ErichStyger/MCU-Link-MR/README.md

# MCU-Link-MR

Project for the NXP MCU-Link Debug Probe with KiCAD, as a debug drone for mobile robotics platforms.

This project is hosted on GitHub: https://github.com/ErichStyger/MCU-Link-MR

See https://mcuoneclipse.com/2024/05/05/cmsis-dap-debug-probe-for-robots-and-pixhawk-with-kicad/

You can order the v0.2 board as produced by NXP: https://www.nxp.com/design/design-center/software/development-software/mcuxpresso-software-and-tools-/mcu-link-mr-debug-probe-with-usb-c-serial-and-mobile-robotics-i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. See the package content and getting started at https://mcuoneclipse.com/2025/04/13/mcu-link-mr-affordable-cmsis-dap-debug-probe-for-robotics-and-beyond/ 

## Features
The MCU-Link-MR is an open source debug probe, based on the original [NXP MCU-Link](https://www.nxp.com/design/design-center/software/development-software/mcuxpresso-software-and-tools-/mcu-link-debug-probe:MCU-LINK).

The MCU-Link-MR supports debugging ARM-Cortex devices plus includes multiple headers used for robots and drone projects.

- Binary firmware compatibility with the original MCU-Link debug probe
- Size: 58x40 mm, dual-layer PCB
- Laser-cut top-cover enclosure
- USB-C host connector
- Reset button for debug probe (LPC55S69) and target
- [ARM target debug header (10pin 2x1.27 mm)](https://developer.arm.com/documentation/101416/0100/Hardware-Description/Target-Interfaces/Cortex-Debug--10-pin-) to debug any ARM Cortex target
- Multiple robot and drone debug and UART connectors:
    - [Pixhawk Debug Full debug header (10pin JST-SH)](https://docs.px4.io/main/en/debug/swd_debug.html#pixhawk-debug-full) with UART
    - [Pixhawk Debug Mini debug header (6pin JST-SH)](https://docs.px4.io/main/en/debug/swd_debug.html#pixhawk-debug-mini) with UART
    - [DCD-LZ Debug header (7pin JST-GHS)](https://nxp.gitbook.io/hovergames/rddrone-fmuk66/connectors/debug-interface-dcd-lz) with UART
    - [Target UART for NavQPlus Companion Computer (6pin JST-GH)](https://nxp.gitbook.io/navqplus/hardware/hardware-interfaces/uart/uart2-a53-debug), supporting flow control (CTS/RTS) (with board rev 0.4 or later)

## PCB
Renderings below show the v0.2 version.
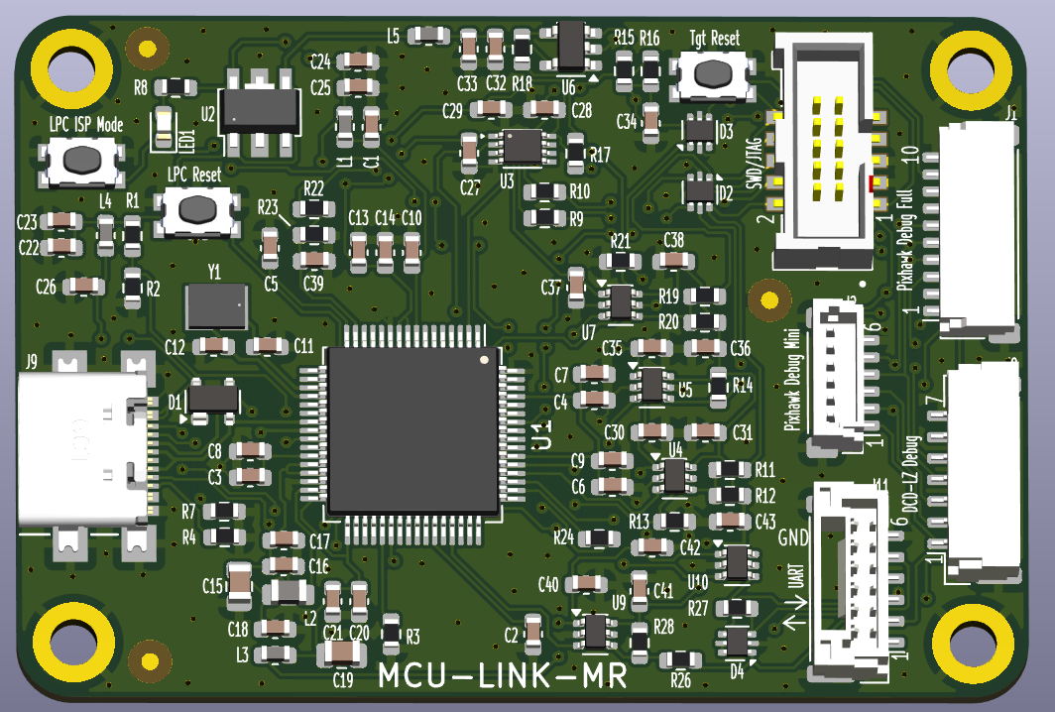
[picture p1: images/top_v0.2.png]
top PCB

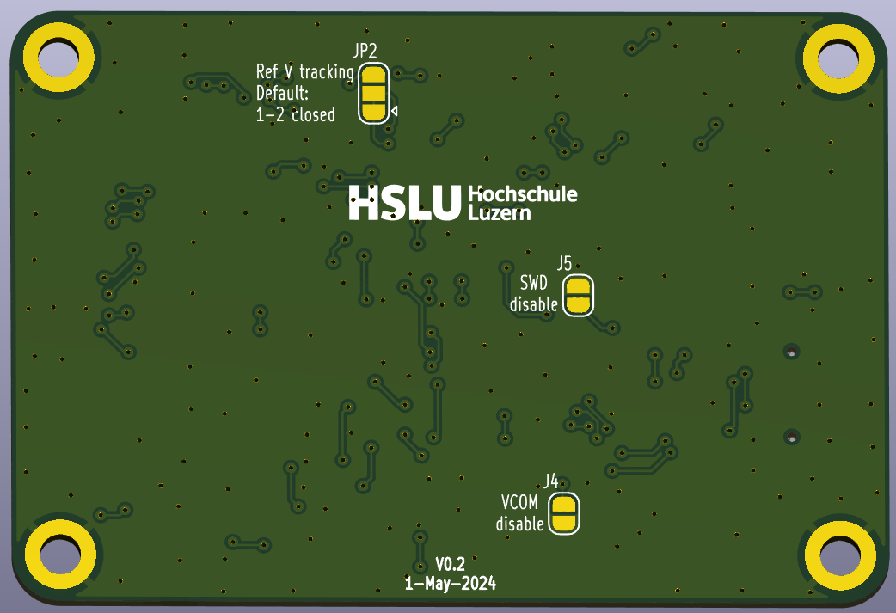
[picture p2: images/bottom_v0.2.png]
bottom PCB

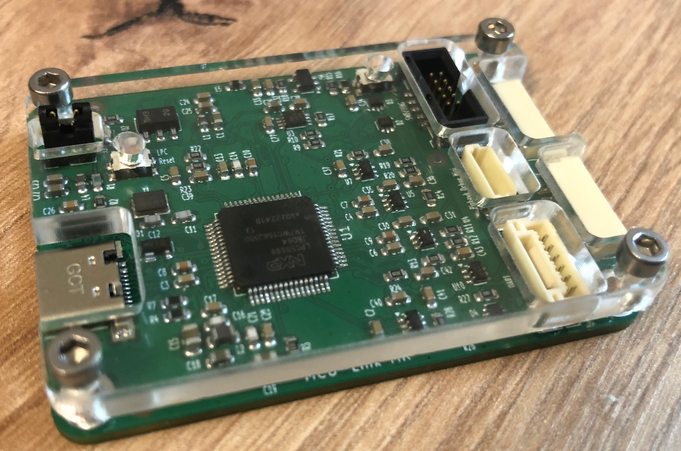
[picture p3: images/enclosure_v0.1.png]
enclosure


### v0.1
The first v0.1 version and the v0.2 version:

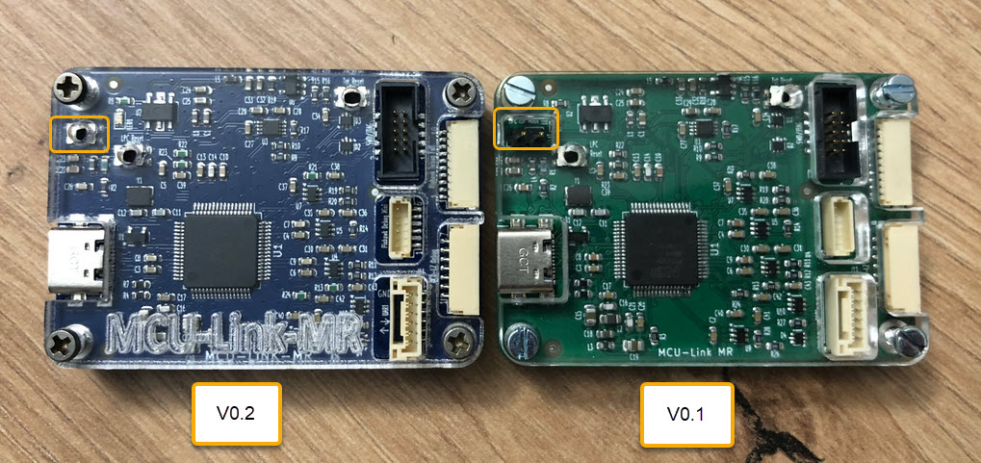
[picture p4: images/mcu-link-mr-v0.1-v0.2.jpg]
v0.1 and v0.2


### v0.2
PCB of the v0.2:

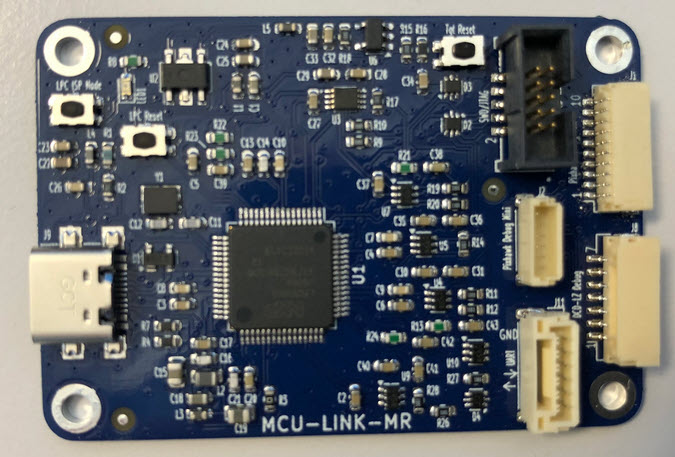
[picture p5: images/mcu-link-mr-v0.2.jpg]

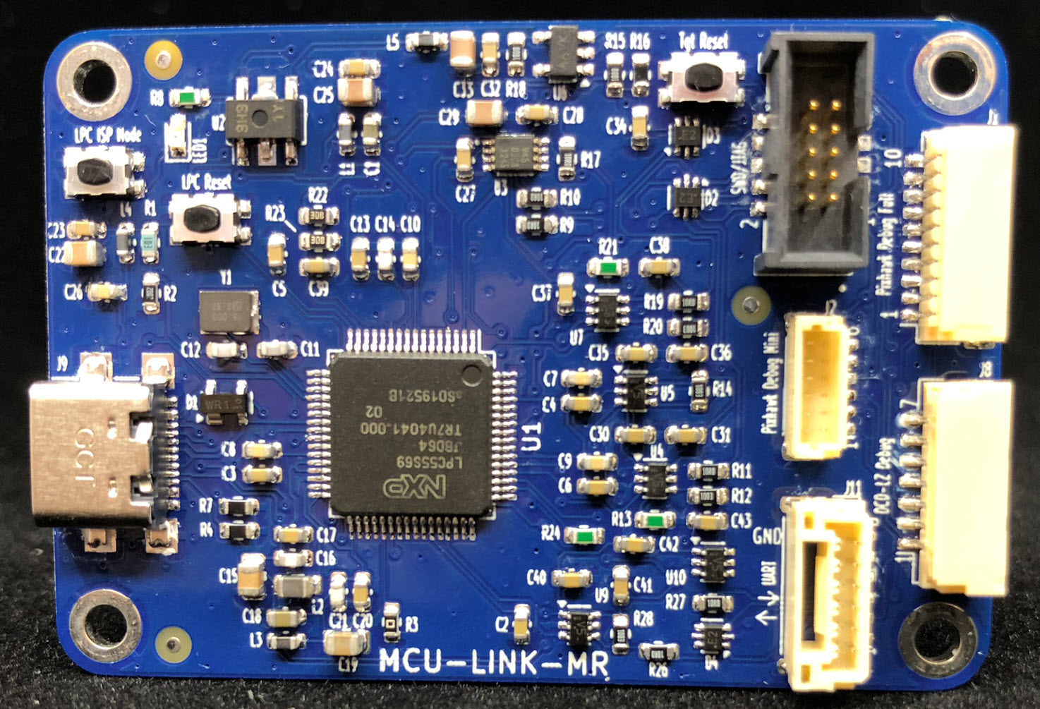
[picture p6: images/v0.2.jpg]

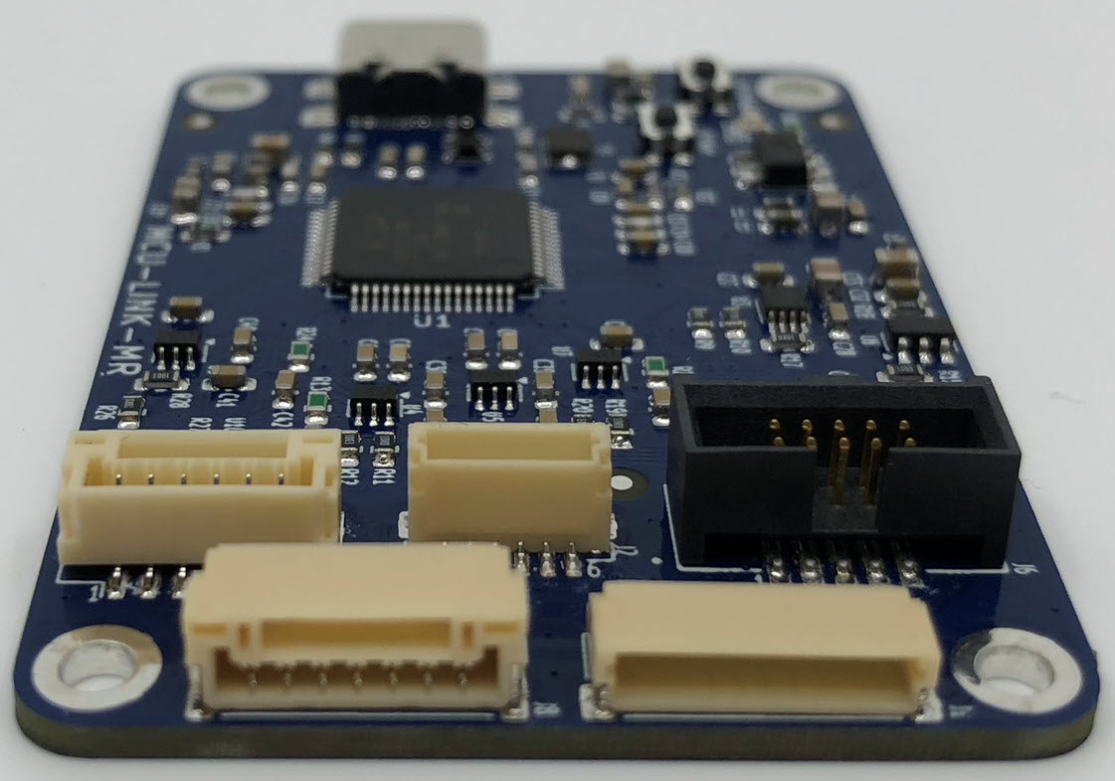
[picture p7: images/v0.2_side1.jpg]
v0.2 side 1

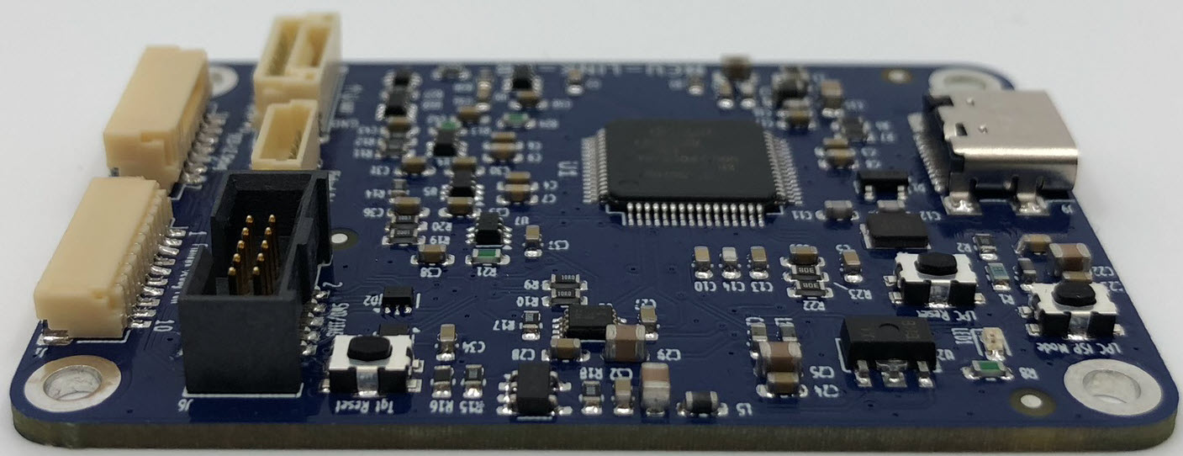
[picture p8: images/v0.2_side2.jpg]
v0.2 side 2

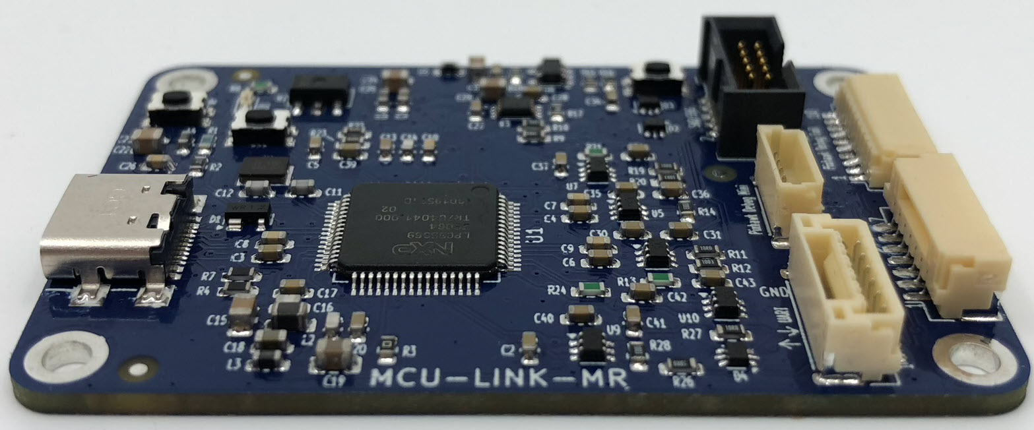
[picture p9: images/v0.2_side3.jpg]
v0.2 side 3

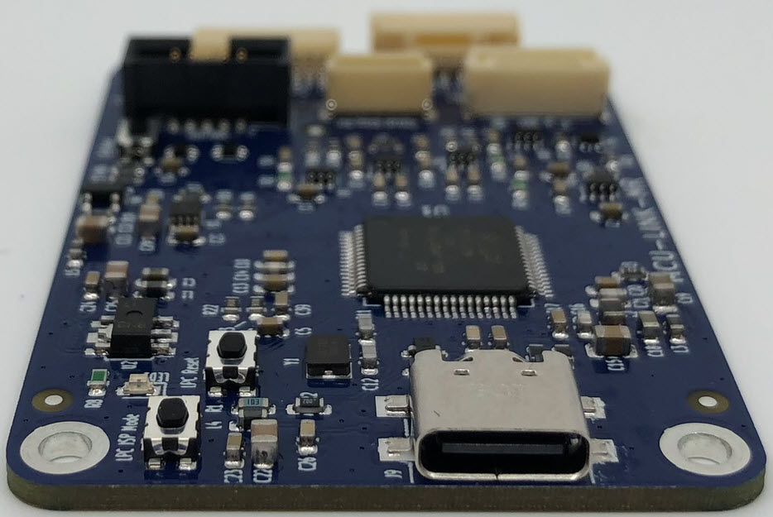
[picture p10: images/v0.2_side4.jpg]
v0.2 side 4


### v0.3
PCB of the v0.3:

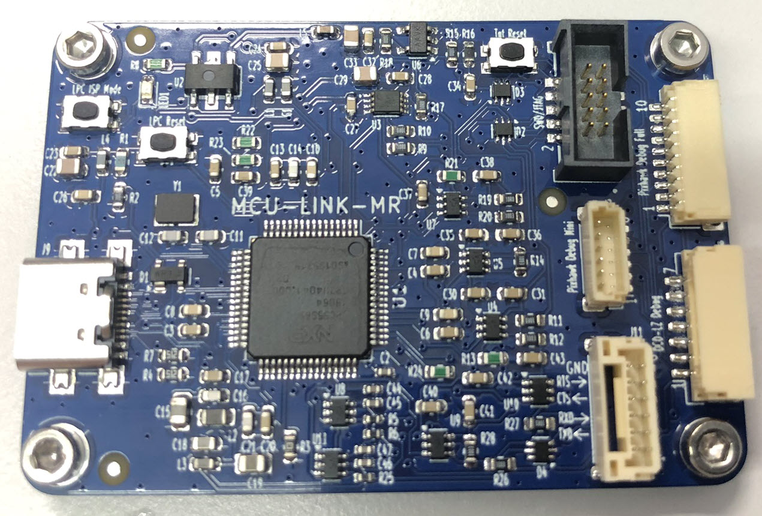
[picture p11: images/mcu-link-mr-v0.3.jpg]
v0.3 PCB

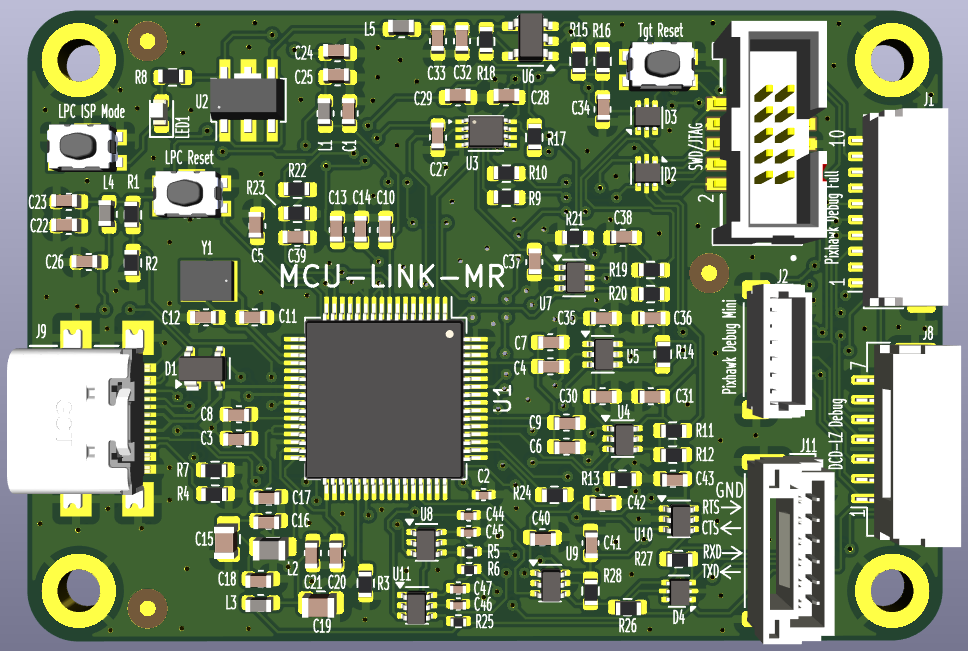
[picture p12: images/top_v0.3.png]
v0.3 top PCB

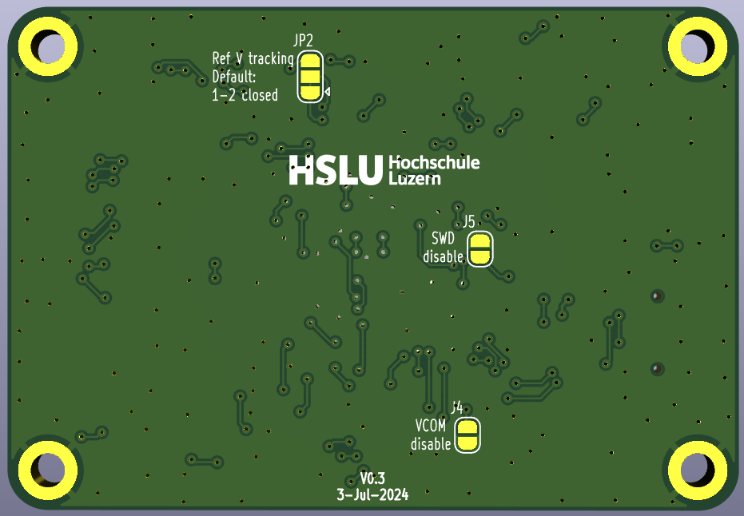
[picture p13: images/bottom_v0.3.png]
v0.3 bottom PCB


### v0.4
PCB of the v0.4:

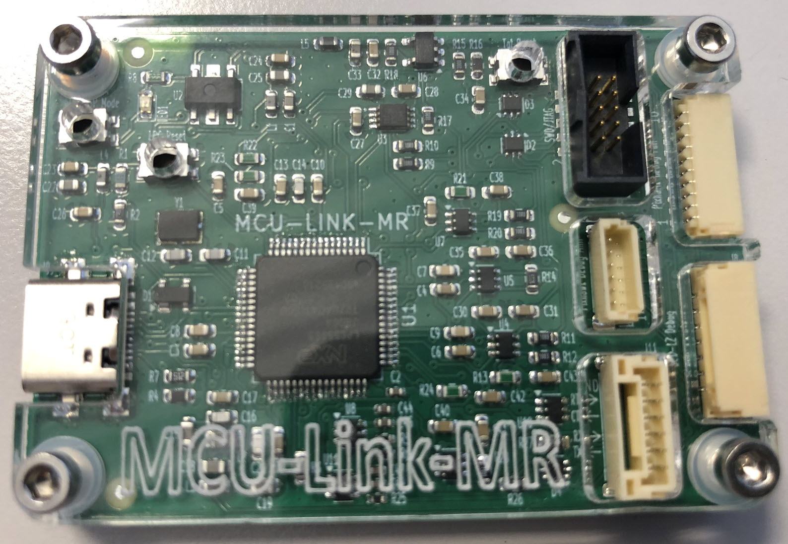
[picture p14: images/mcu-link-mr-v0.4.jpg]
v0.4 PCB

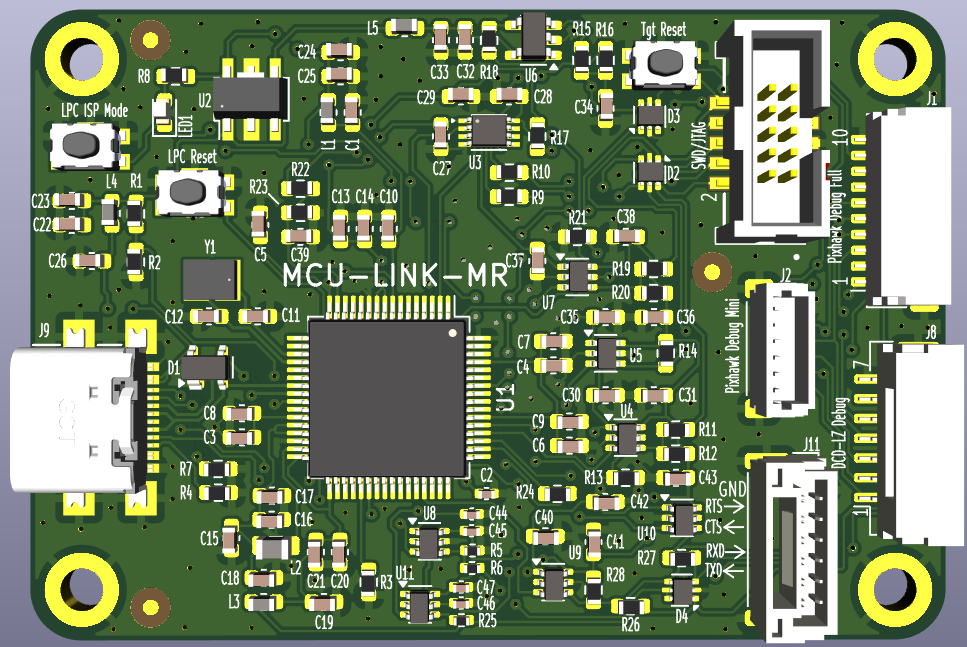
[picture p15: images/top_v0.4.png]
v0.4 top PCB

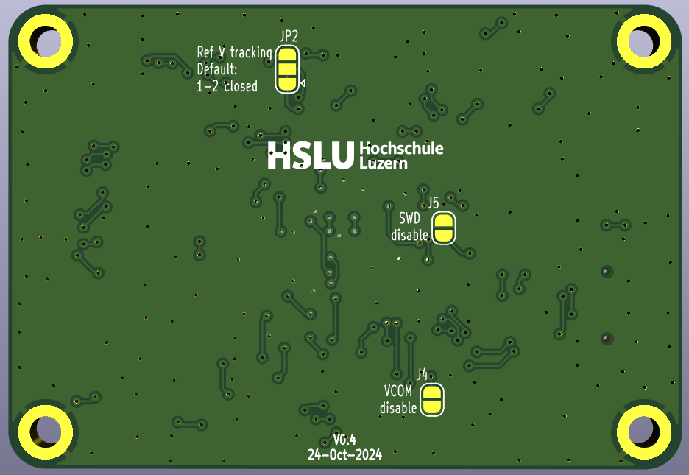
[picture p16: images/bottom_v0.4.png]
v0.4 bottom PCB


PCB of the v0.5:

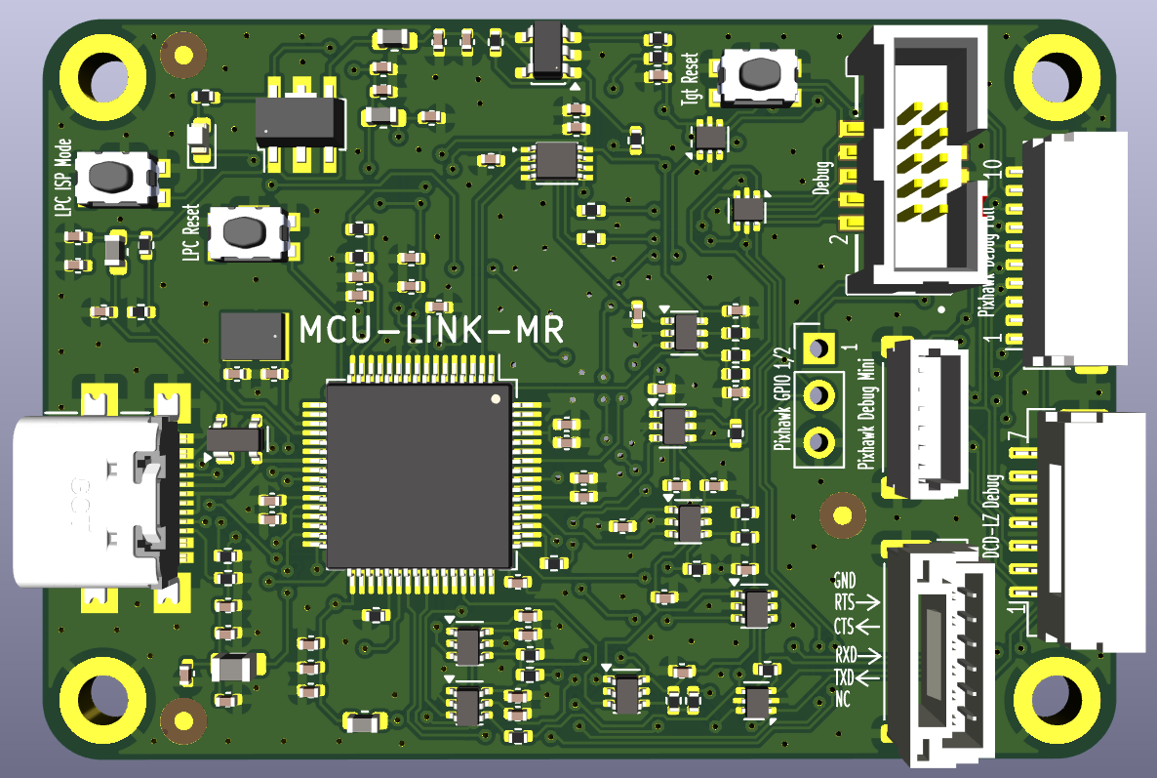
[picture p17: images/top_v0.5.png]
v0.45 top PCB

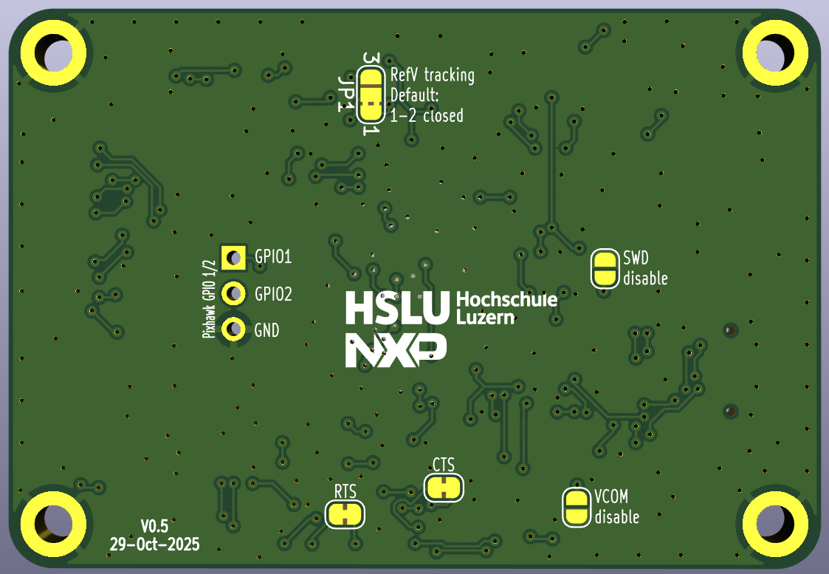
[picture p18: images/bottom_v0.5.png]
v0.5 bottom PCB

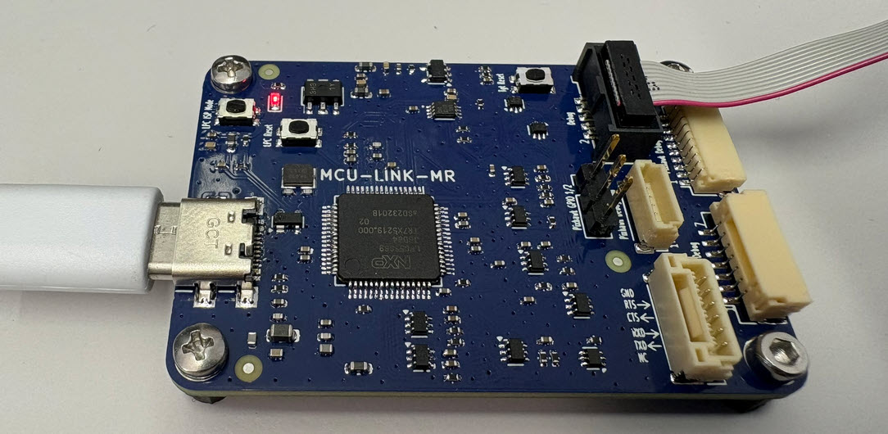
[picture p19: images/mcu-link-mr-v05.jpg]
v0.5 PCB


## Versions
The gerber files for the different releases can be found in KiCAD project directory.

### v0.5
- Upgraded to KiCad v9.0
- added isolation solder-jumpers for RTS and CTS
- changed Resistor and Capacitor size from 0603 to 0402
- removed all designators on silkscreen
- added 3 pin 2.54mm Pixhawk header for logic analyzer access
- added NXP logo on the back
- see https://mcuoneclipse.com/2025/12/29/mcu-link-mr-v0-5-enhanced-debug-probe-for-arm-cortex-m/

### v0.4
- fixed pull-up on CTS line to pull-down

### v0.3
- Added RTS/CTS signals with level shifters for J11/NavQPlus connector
- Issue: this PCB has pull-ups for the CTS line instead of pull-down. Fixed in v0.4

### v0.2
- Improved footprints and silkscreen
- Push button instead of jumper for DFU mode
- fixed UART connection on debug headers

### v0.1
- Initial version
- Issue with UART on debug headers (works fine on UART header) (fixed in v0.2)

## PCB Production
PCBs have been produced by PCBWay (https://www.pcbway.com/), with following settings:
- Size: 58x40 mm
- Layers: 2
- Soldermask (top, bottom): blue *(Note: green is possible too, PCBWay won't accept black because this requires minimal 0.22 mm soldermask distance between pins)*
- Silkscreen (top, bottom): white
- Material: FR4, TG 150-160
- Thickness: 1.6 mm
- Min track/spacing: 6/6 mil
- Min hole size: 0.3 mm
- Surface finish: HASL with lead *(Note: for production use HASL lead free or immersion gold (ENIG))*
- Vias: tenting vias
- Finished copper: 1 oz Cu

## Links
- Article about production version: https://mcuoneclipse.com/2025/04/13/mcu-link-mr-affordable-cmsis-dap-debug-probe-for-robotics-and-beyond/
- Article about v0.2: https://mcuoneclipse.com/2024/05/19/mcu-link-mr-v0-2-drone-and-robot-debug-probe-with-uart-2-usb-bridge/
- Article for the project: https://mcuoneclipse.com/2024/05/05/cmsis-dap-debug-probe-for-robots-and-pixhawk-with-kicad/
- Base hardware project used: https://mcuoneclipse.com/2024/02/06/versatile-oshw-mini-mcu-link-debug-probe-external-on-board-or-embedded/, GitHub: https://github.com/ErichStyger/McuLink-Mini
- NXP MCU-Link: https://www.nxp.com/design/design-center/software/development-software/mcuxpresso-software-and-tools-/mcu-link-debug-probe:MCU-LINK
- NXP LinkServer: https://www.nxp.com/design/design-center/software/development-software/mcuxpresso-software-and-tools-/linkserver-for-microcontrollers:LINKERSERVER
- MCU-Link with Cortex-Debug and LinkServer: https://mcuoneclipse.com/2023/11/27/mcu-link-with-cortex-debug-and-linkserver/
- LinkServer for Microcontrollers: https://mcuoneclipse.com/2023/05/14/linkserver-for-microcontrollers/
