ErichStyger/MCU-Link-MR/enclosure/README.md

# Enclosure
Enclosure files (lasercut) for the debug probe.
See file name for the different versions.
