ErichStyger/MCU-Link-MR/KiCAD/README.md

# KiCAD
Folder for KiCAD project and files.
