ErichStyger/MCU-Link-MR/KiCAD/MCU-Link_MR/bom/BOM.xlsx

Mouser | Vendor | Description | 1 | 10
200-SHF10501LDSM | SHF-105-01-L-D-SM | Sockel & Kabelgehäuse Shrouded Terminal Strip, 0.050" pitch | 2.88 | 2.62
771-LPC55S69JBD64K | LPC55S69JBD64K | LPC55S69JBD64 | 8.13 | 5.6
771-74LVC1T45GWQ100H | 74LVC1T45GW-Q100H | voltage converter 74LVC1T45GW-Q100/SOT363/SC-88 | 0.398 | 0.335
771-74LVC2T45DC125 | 74LVC2T45DC,125 | dual voltage converter/Bus transceiver | 0.658 | 0.546
