ErichStyger/MCU-Link-MR/(threads)

Thread 1 (2025-04-02):

MCU-Link-MR bricked after failed firmware update in MCUXpresso, how to recover?

eldux, 2025-04-02:
MCU-Link-MR bricked after failed firmware update in MCUXpresso, how to recover? Pressing ISP button as per instructions here does not work:
https://docs.nxp.com/bundle/UM12219/page/topics/installation_and_firmware_options.html

ErichStyger, 2025-04-02:
You can update it with a script, with or without jumper/button pressed,
See https://mcuoneclipse.com/2024/05/11/updating-mcu-link-cmsis-dap-debug-probe-firmware-jumper-less/, section 'Firmware update script'.

Or use
LinkServer probe #1 update check
and then
LinkServer probe #1 update auto

I hope this helps?
Erich

ErichStyger, 2025-04-02:
Just in case the 'auto' update does not work, here is what I usually do:
a) press the LPC ISP button on the board, and while pressed, plug in the board (USB cable)
b) run the script 'C:\NXP\LinkServer\MCU-LINK_installer\scripts\program_CMSIS.cmd' (Windows)
c) press a key in the launched script as prompted which will re-program the firmware

Below is my output of the script:
```
CMSIS-DAP firmware for MCU-Link programming script V3.153 December 2024.

Place the board in ISP USB mode using the appropriate jumper on your MCU-Link.
Refer to the board documentation for more information.
Connect board via USB then press Space.

WARNING:

This firmware version requires MCUXpresso IDE version 11.7.1 or later.

Press any key to continue . . .

Programming "MCU-LINK_CMSIS-DAP_V3_153.s19"

Programmed successfully - To use: remove ISP jumper and reboot.

Connect Next Board then press Space (or CTRL-C to Quit)

Press any key to continue . . .
```
I hope this helps

eldux, 2025-04-02:
actually i did try to do that and it stuck on ISP mode request:

CMSIS-DAP firmware for MCU-Link programming script V3.153 December 2024.

Place the board in ISP USB mode using the appropriate jumper on your MCU-Link.
Refer to the board documentation for more information.
Connect board via USB then press Space.

WARNING:

This firmware version requires MCUXpresso IDE version 11.7.1 or later.

Press any key to continue . . .

Configure board for ISP mode and connect via USB then press Space.
Press any key to continue . . .
Configure board for ISP mode and connect via USB then press Space.
Press any key to continue . . .
Configure board for ISP mode and connect via USB then press Space.
Press any key to continue . . .
Configure board for ISP mode and connect via USB then press Space.
Press any key to continue . . .
Configure board for ISP mode and connect via USB then press Space.
Press any key to continue . . .
Configure board for ISP mode and connect via USB then press Space.
Press any key to continue . . .
Configure board for ISP mode and connect via USB then press Space.
Press any key to continue . . .

ErichStyger, 2025-04-02:
So the board is not in ISP mode as it seems.
Did you keep the ISP button pressed while powering the board?
In that mode no LED should be on.
(you can release the button after the power-on, but you need to keep it pressed during power-on).

eldux, 2025-04-02:
Yes, it gone like that: I push the button -> plug USB-C -> led goes red, and computer chimes -> depress the button -> no led. I run C:\nxp\LinkServer_25.3.31>linkserver probe #1 update check
and get this:
CRITICAL: Critical error
ERRMSG: Exception: No probes detected

ErichStyger, 2025-04-02:
Strange: LED behavior is correct and same on my side.
Can you run the following when connected in ISP mode:
pnputil /enum-devices /connected | findstr /i "USB\"

It should show a device with VID 1Fc9 and PID 0021:
Instance ID:                USB\VID_1FC9&PID_0021\5&3af188da&0&4

Other than that: maybe you already tried with a different USB cable and with a different machine?

eldux, 2025-04-02:
We have just tied on other PC with other USB-c cable, and your instructions worked now.

ErichStyger, 2025-04-02:
Great that this hint worked :-).
I'm wondering: was it the USB cable or the PC, or both?
