ErichStyger/MCU-Link-MR/KiCAD/MCU-Link_MR/v0.5/Schematics MCU-Link-MR v0.5.pdf

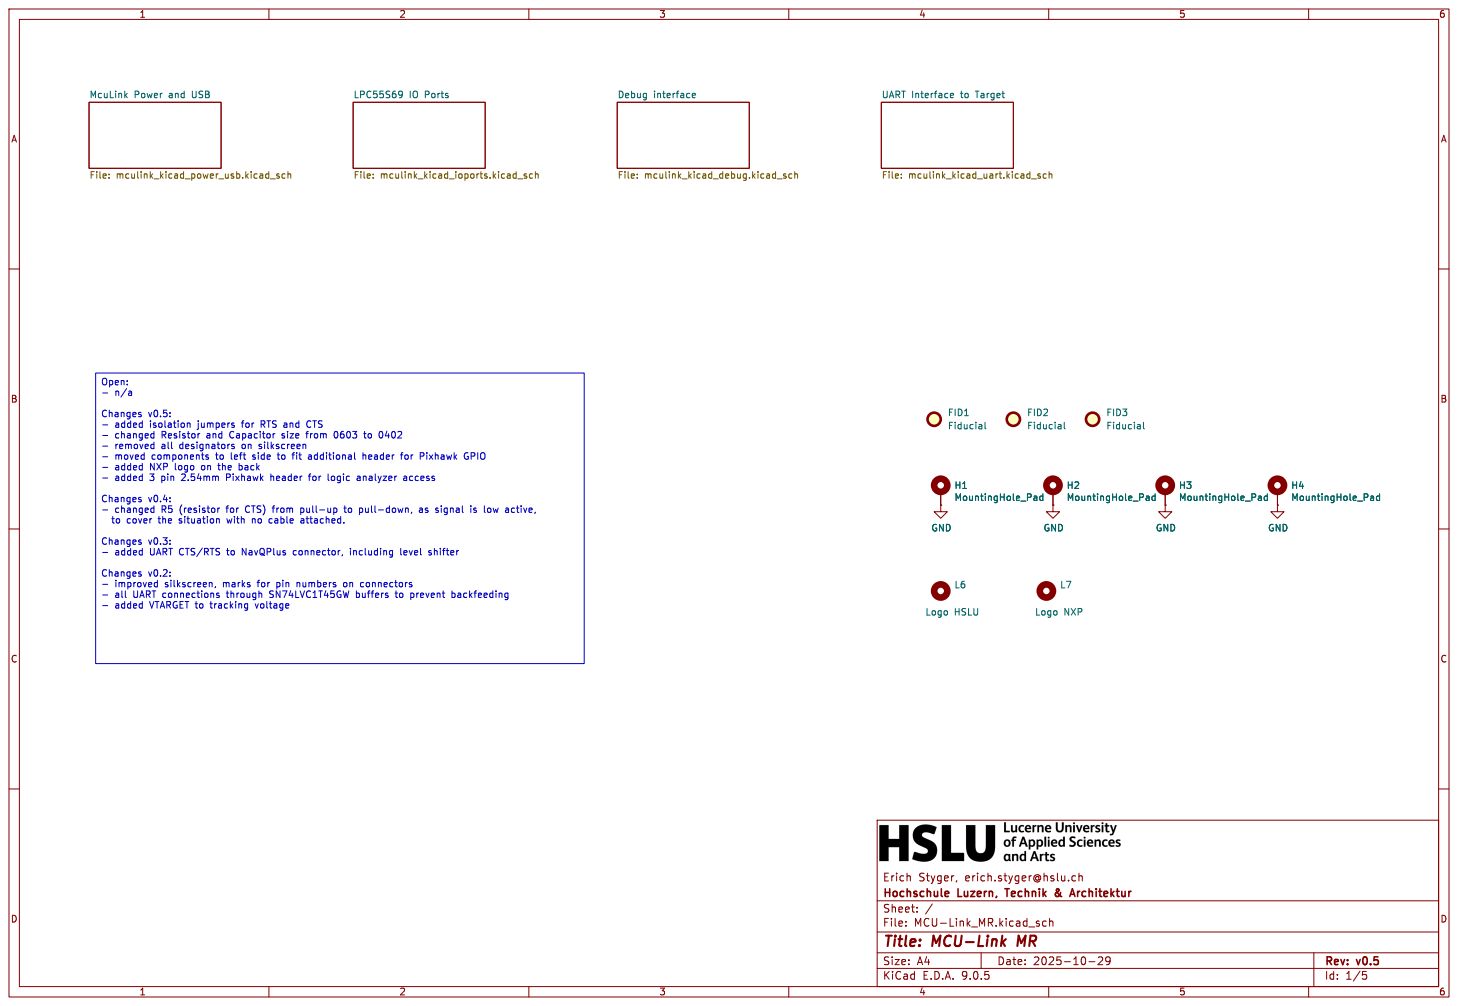
[picture p20: page 1]

- added NXP logo on the back

Id: 1/5 Title: MCU-Link MR

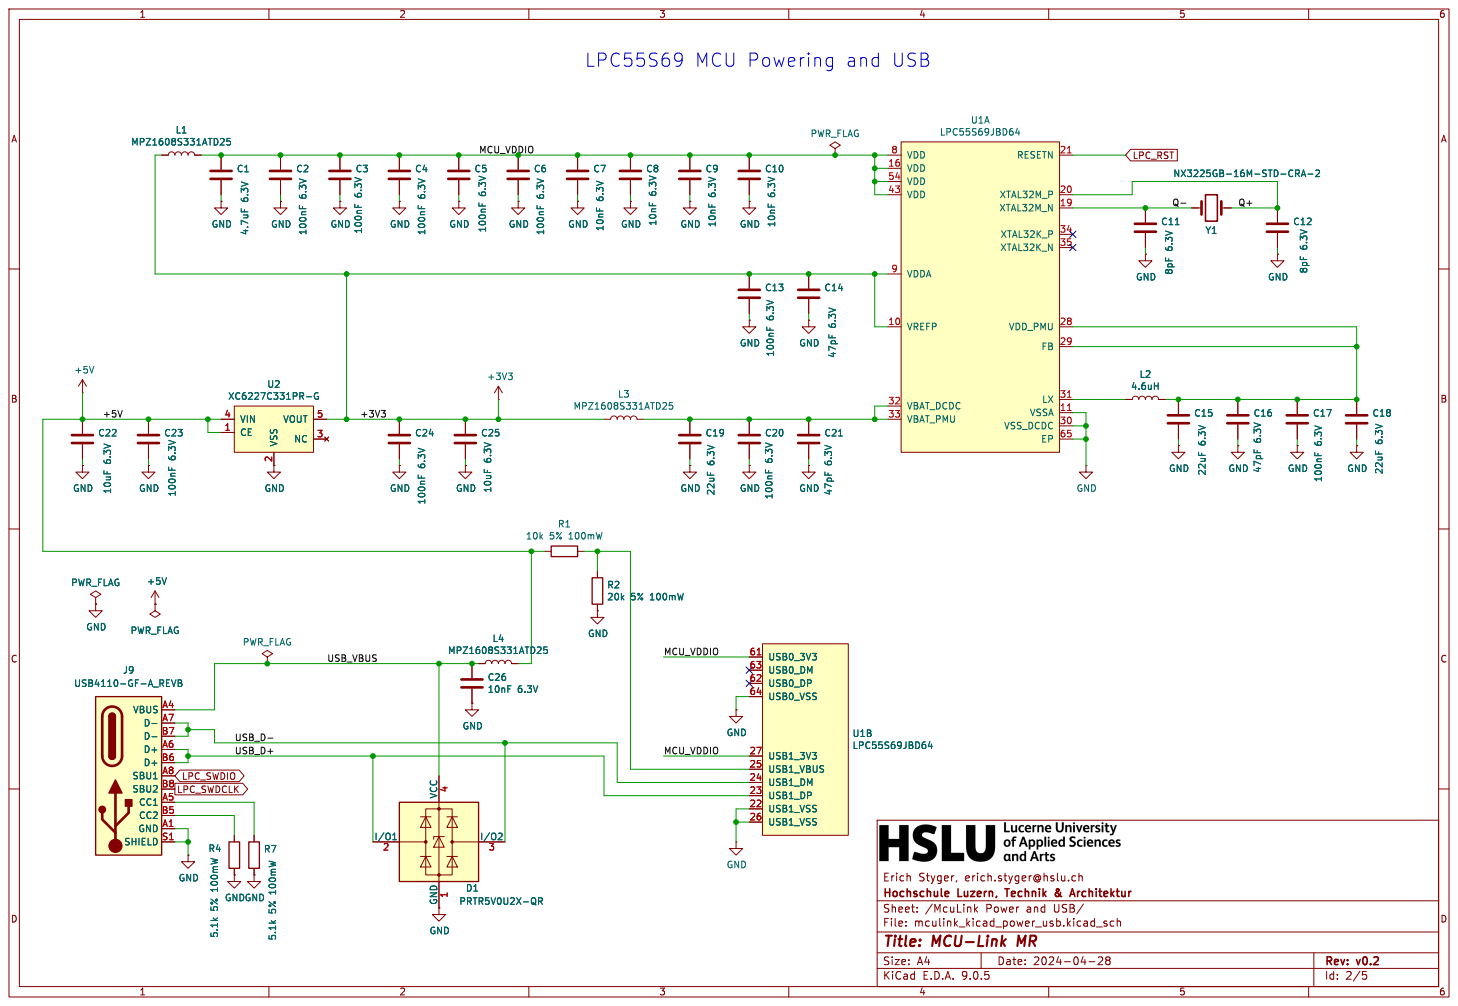
[picture p21: page 2]

2 VOUT 5 NC C23 3 100nF 6.3V GND GND

Id: 2/5 Title: MCU-Link MR

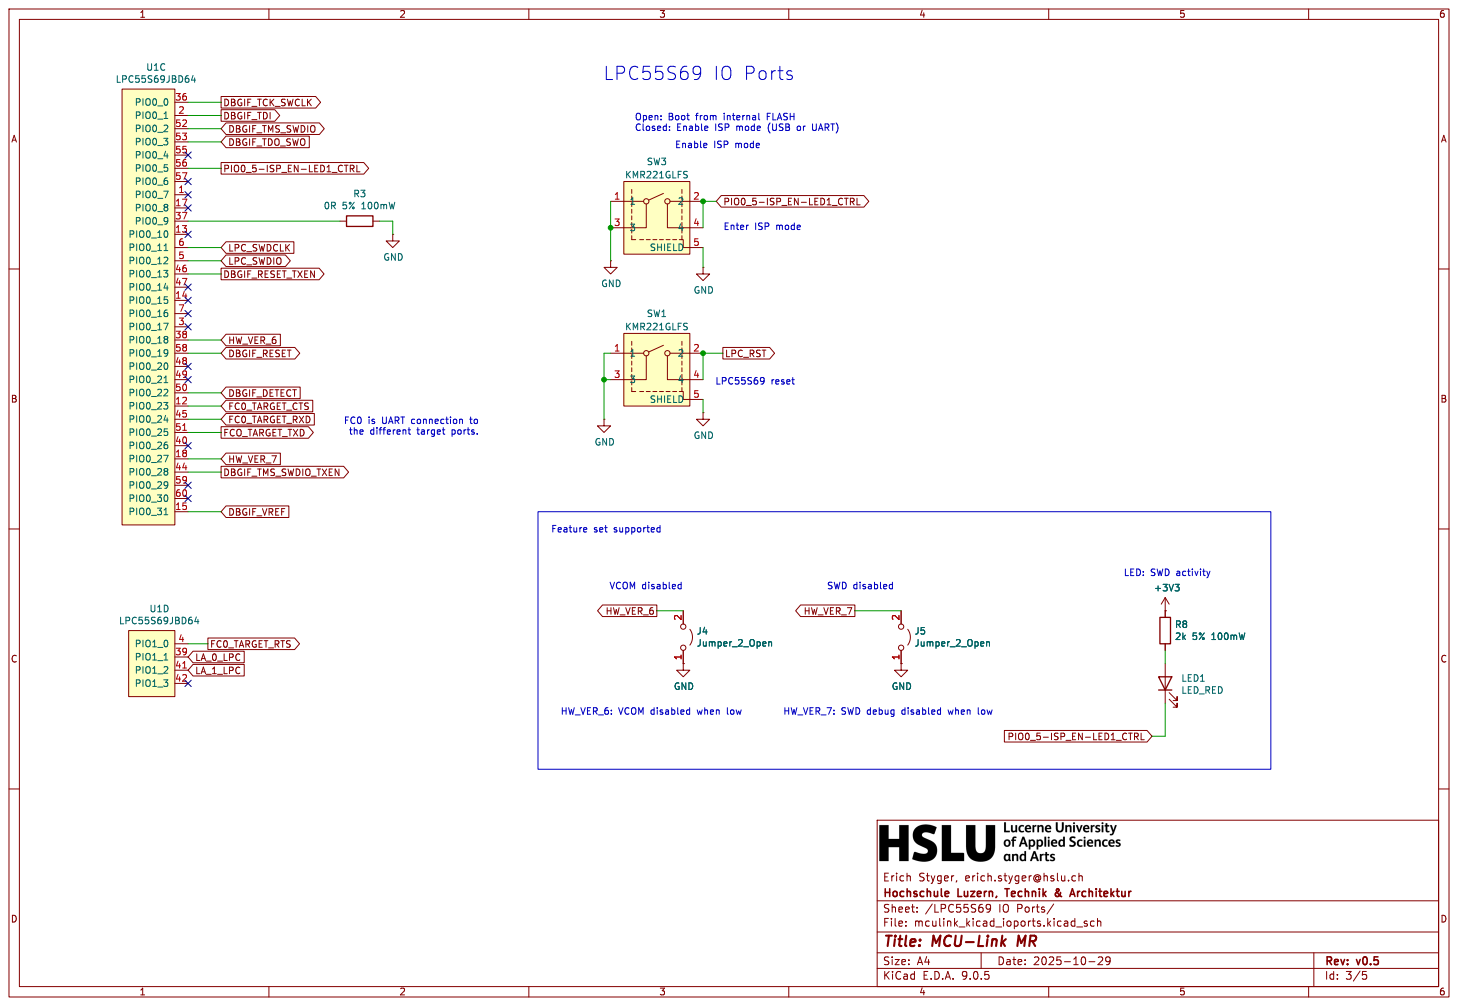
[picture p22: page 3]

LPC55S69 reset Enter ISP mode

Id: 3/5 Title: MCU-Link MR

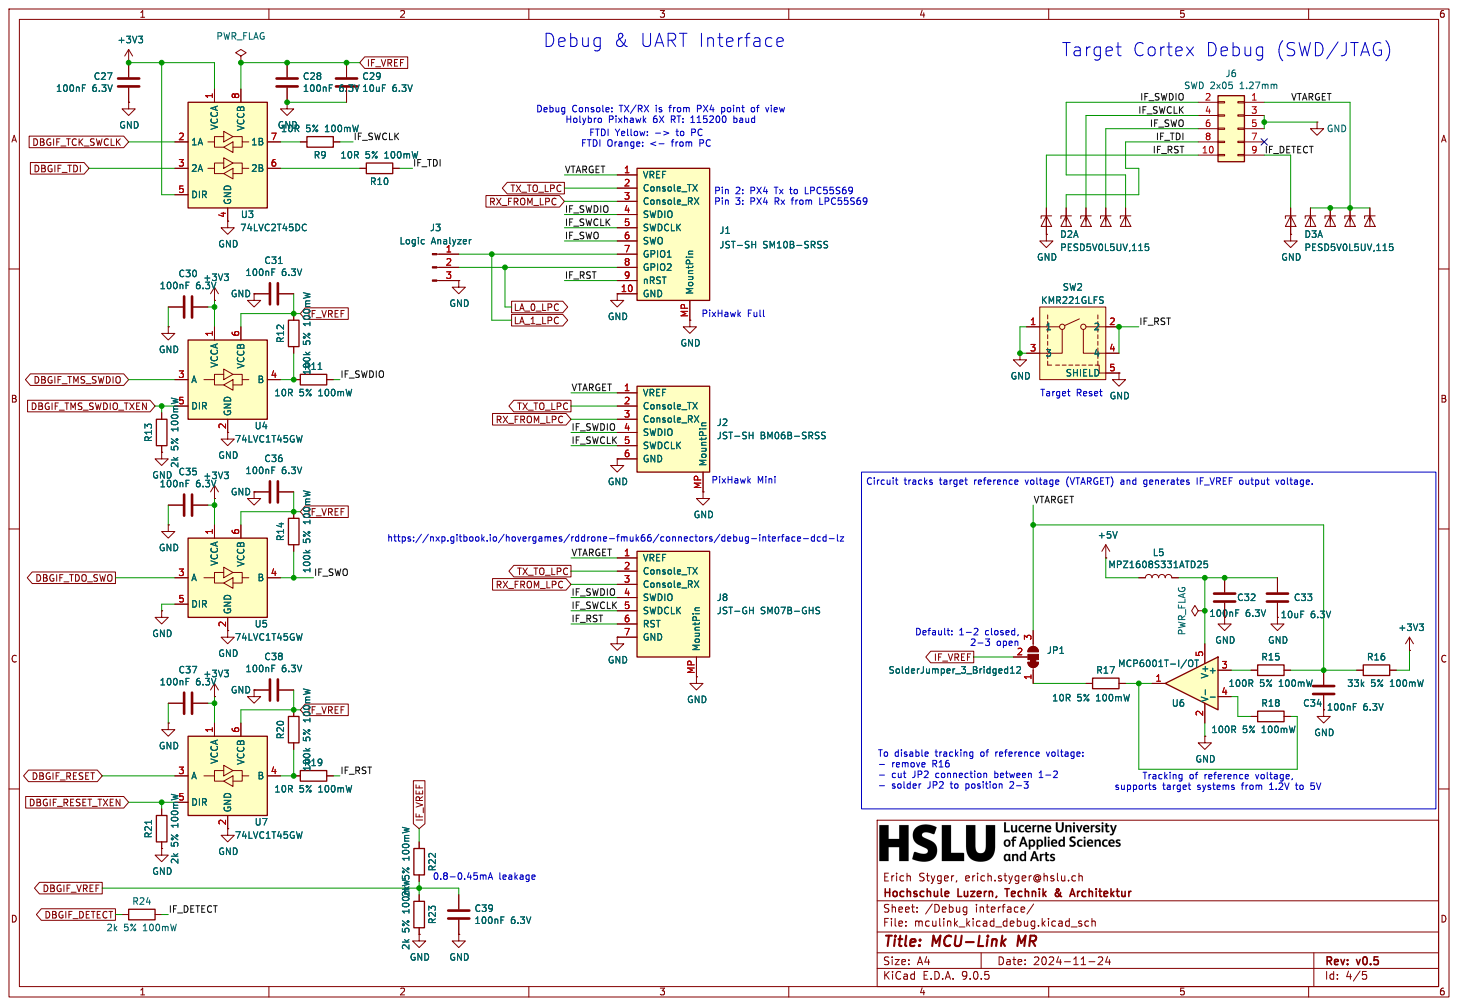
[picture p23: page 4]

Target Cortex Debug (SWD/JTAG)

Debug Console: TX/RX is from PX4 point of view
IF_DETECT VTARGET

Logic Analyzer GND GND
+3V3GND

Id: 4/5 Title: MCU-Link MR

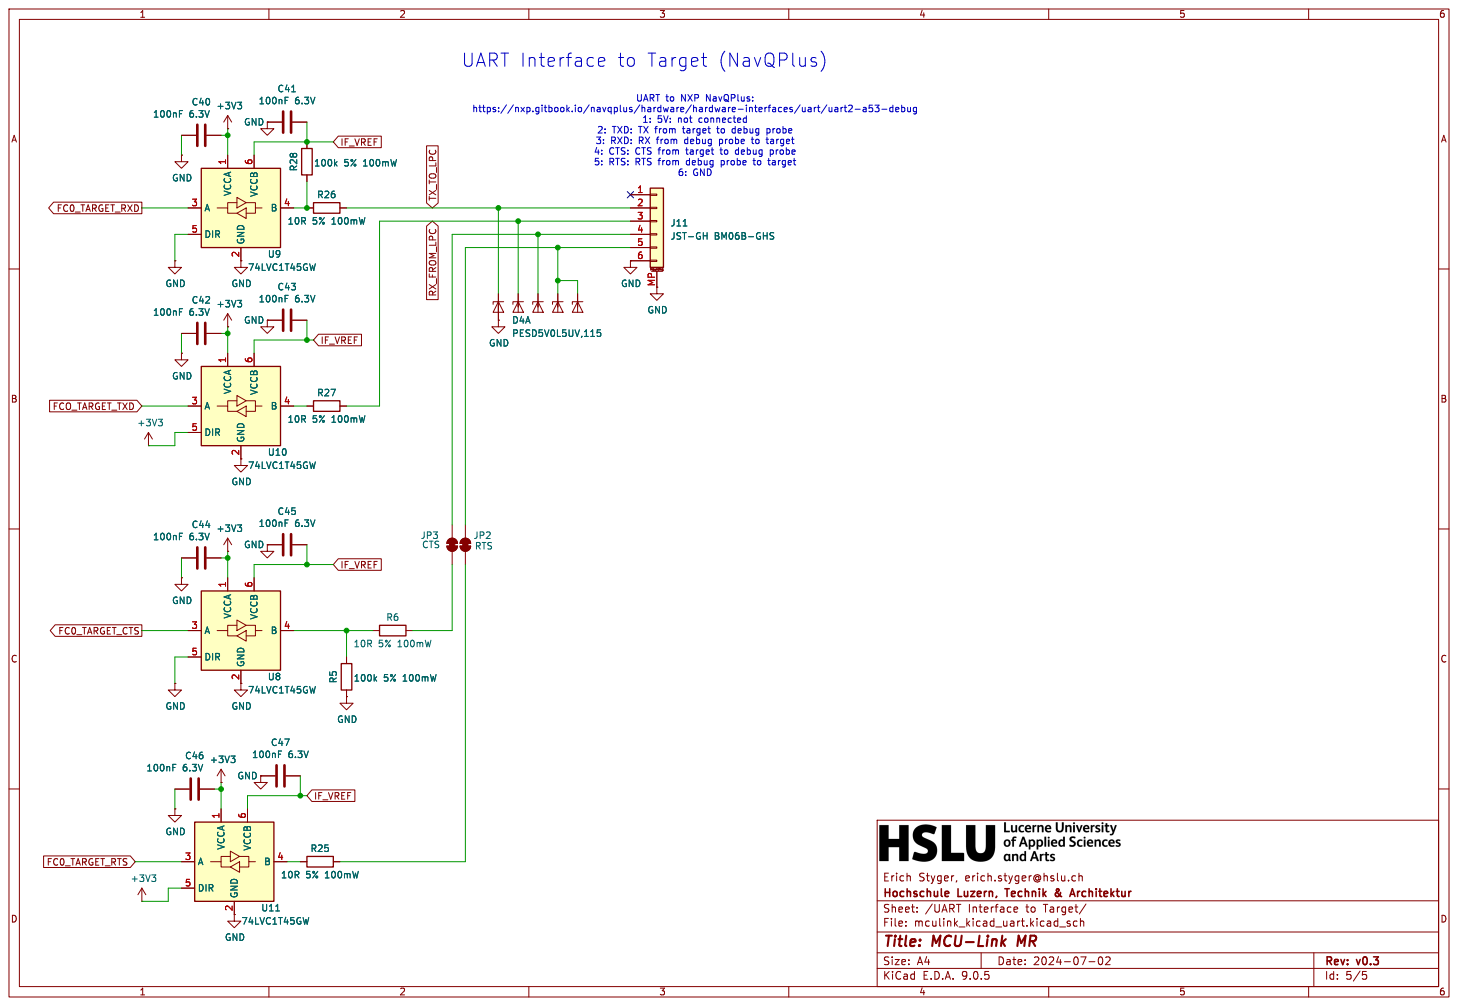
[picture p24: page 5]

5: RTS: RTS from debug probe to target 6: GND UART Interface to Target (NavQPlus) D4A
100nF 6.3V GND GND
100nF 6.3V GND
4 GND GND

UART to NXP NavQPlus: https://nxp.gitbook.io/navqplus/hardware/hardware-interfaces/uart/uart2-a53-debug

2: TXD: TX from target to debug probe
3: RXD: RX from debug probe to target 4: CTS: CTS from target to debug probe

JST-GH BM06B-GHS GND GND
GND

Id: 5/5 Title: MCU-Link MR
