ErichStyger/MCU-Link-MR/KiCAD/MCU-Link_MR/v0.2/Schematics MCU-Link-MR_v0.2.pdf

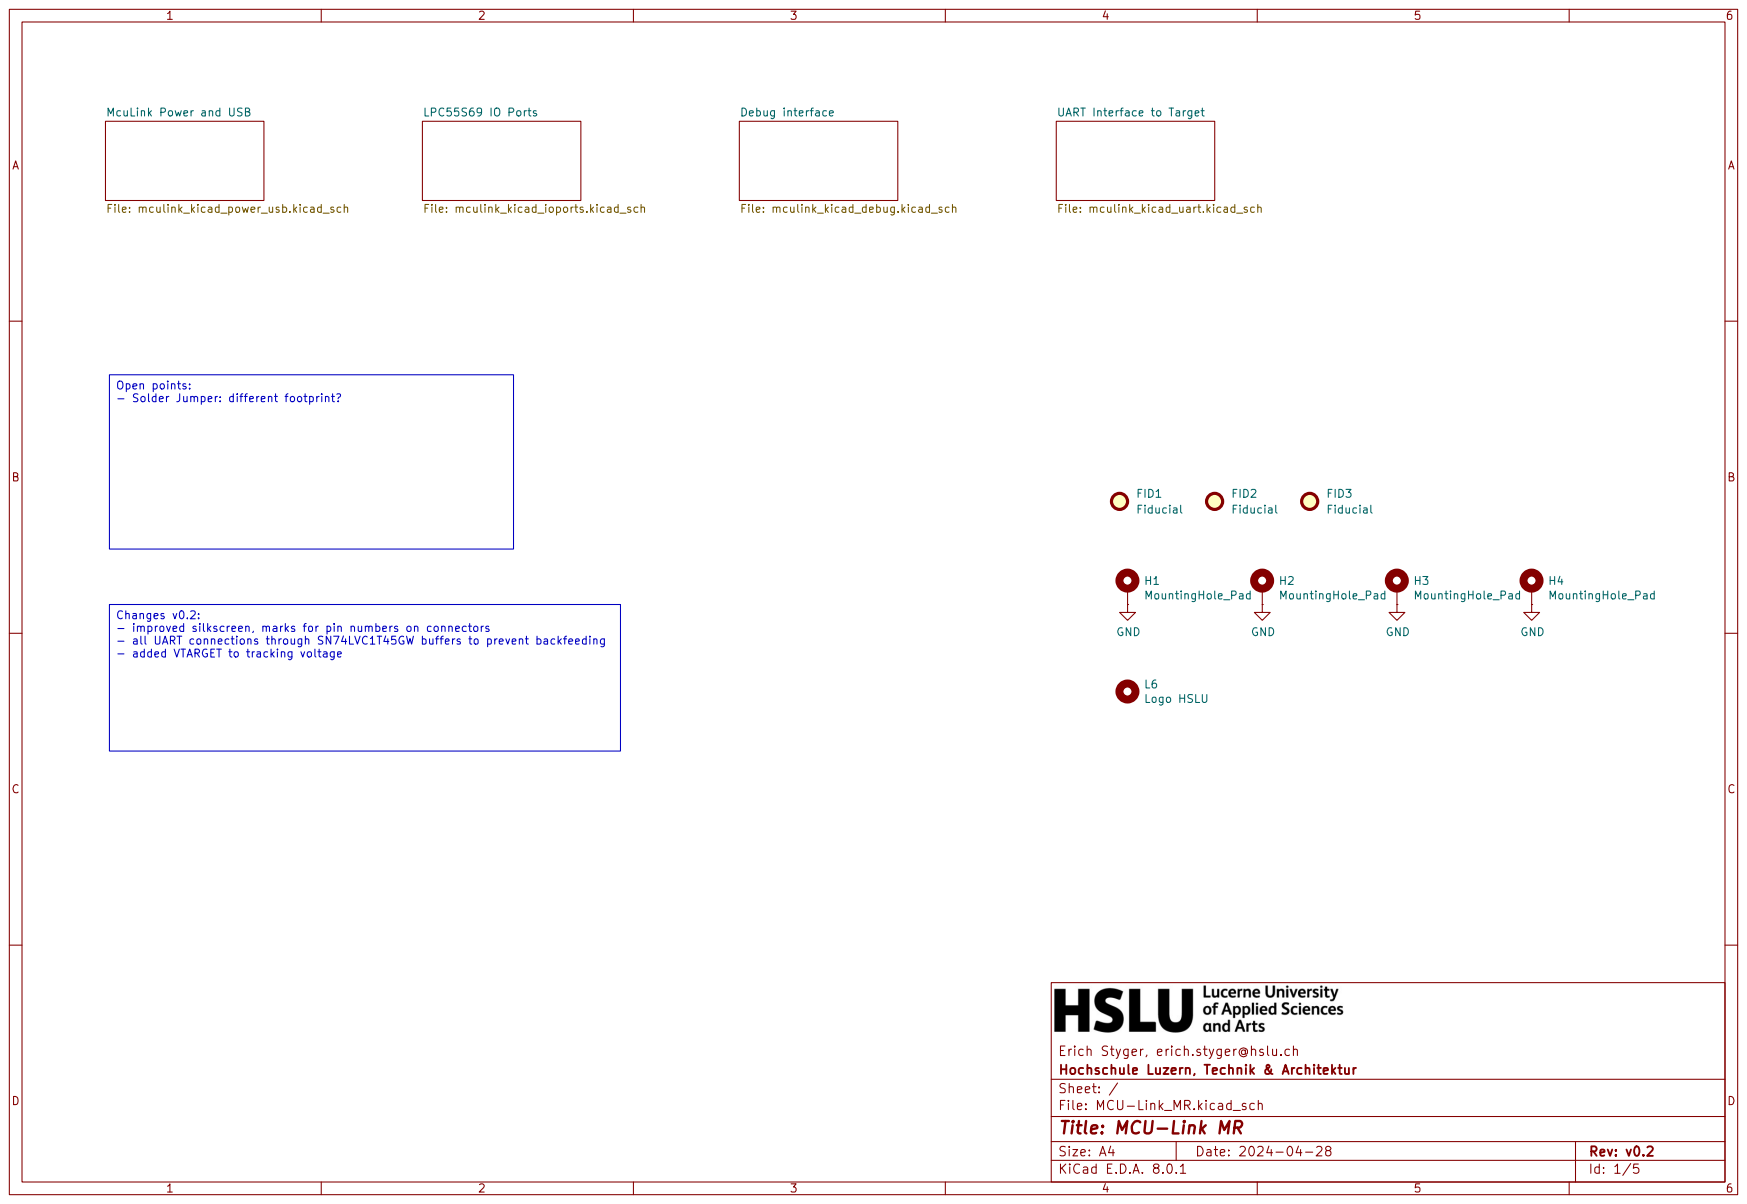
[picture p25: page 1]

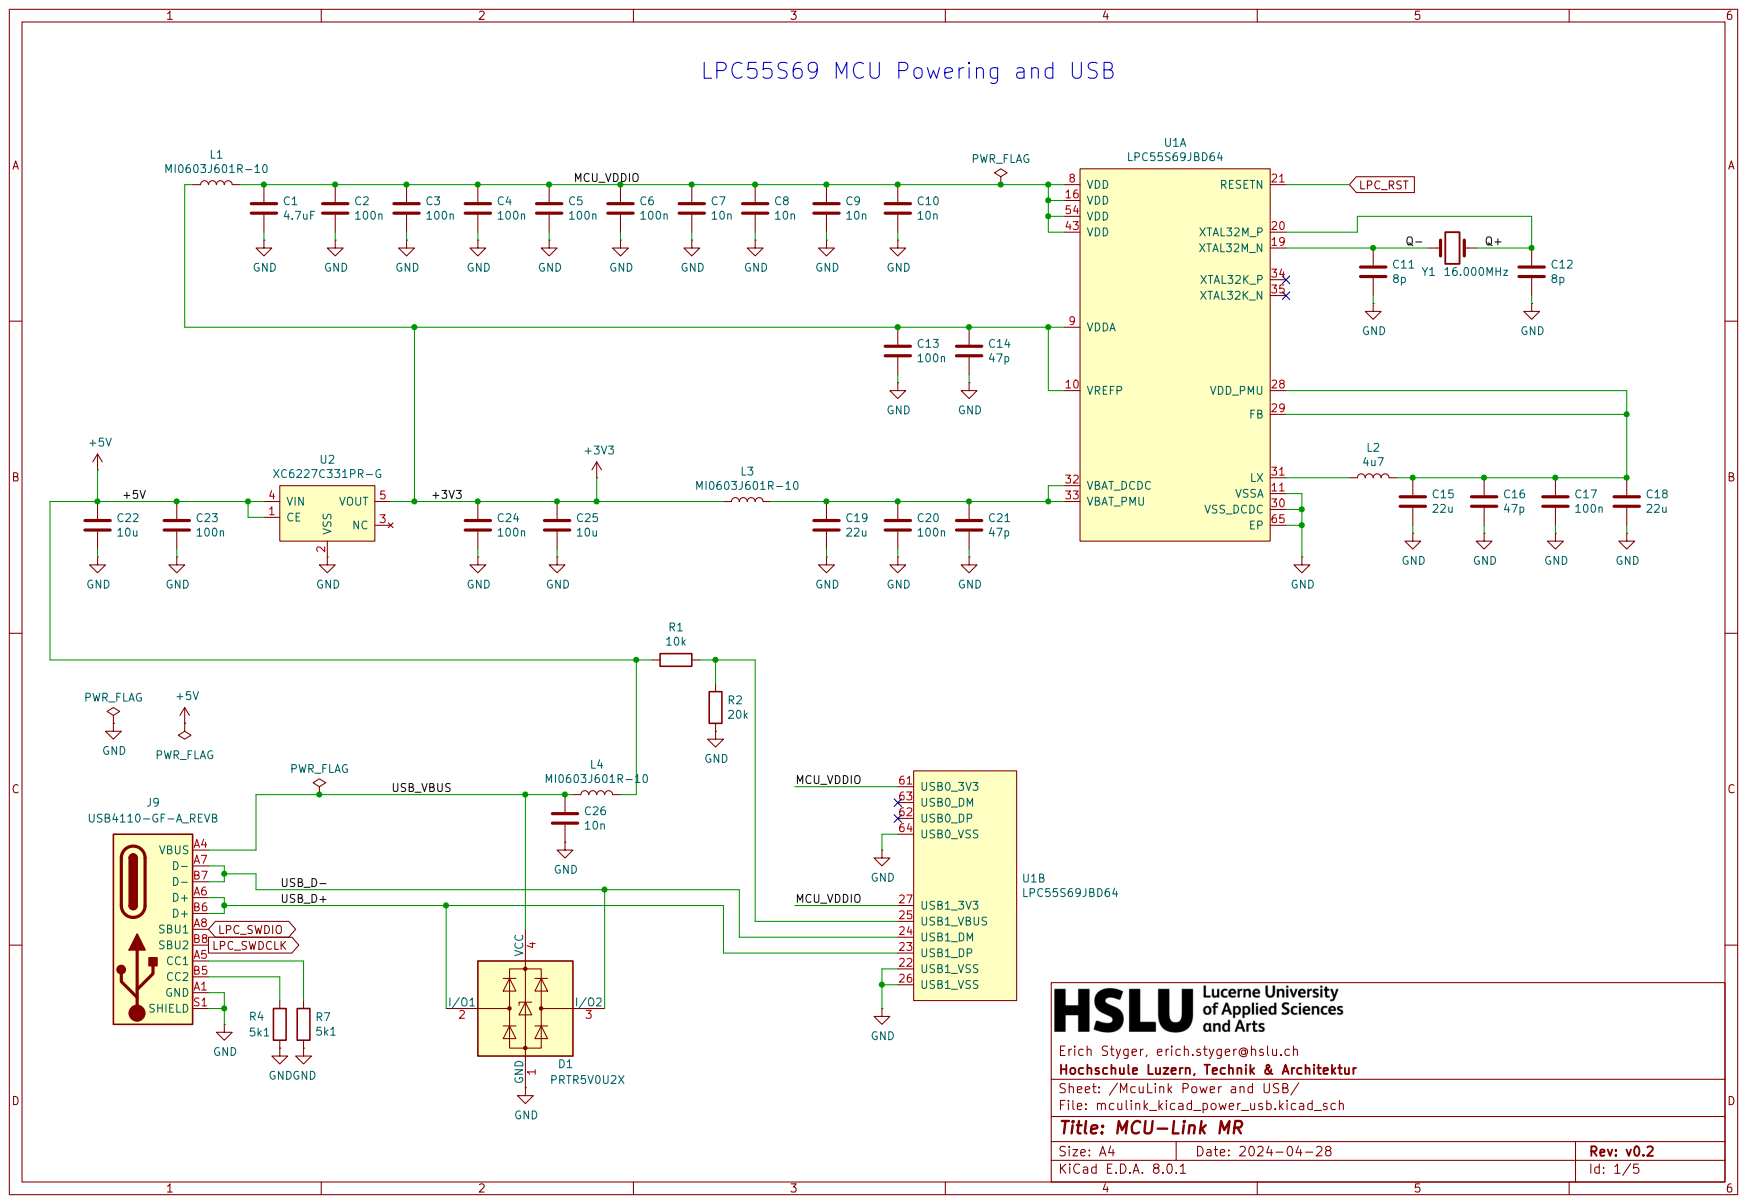
[picture p26: page 2]

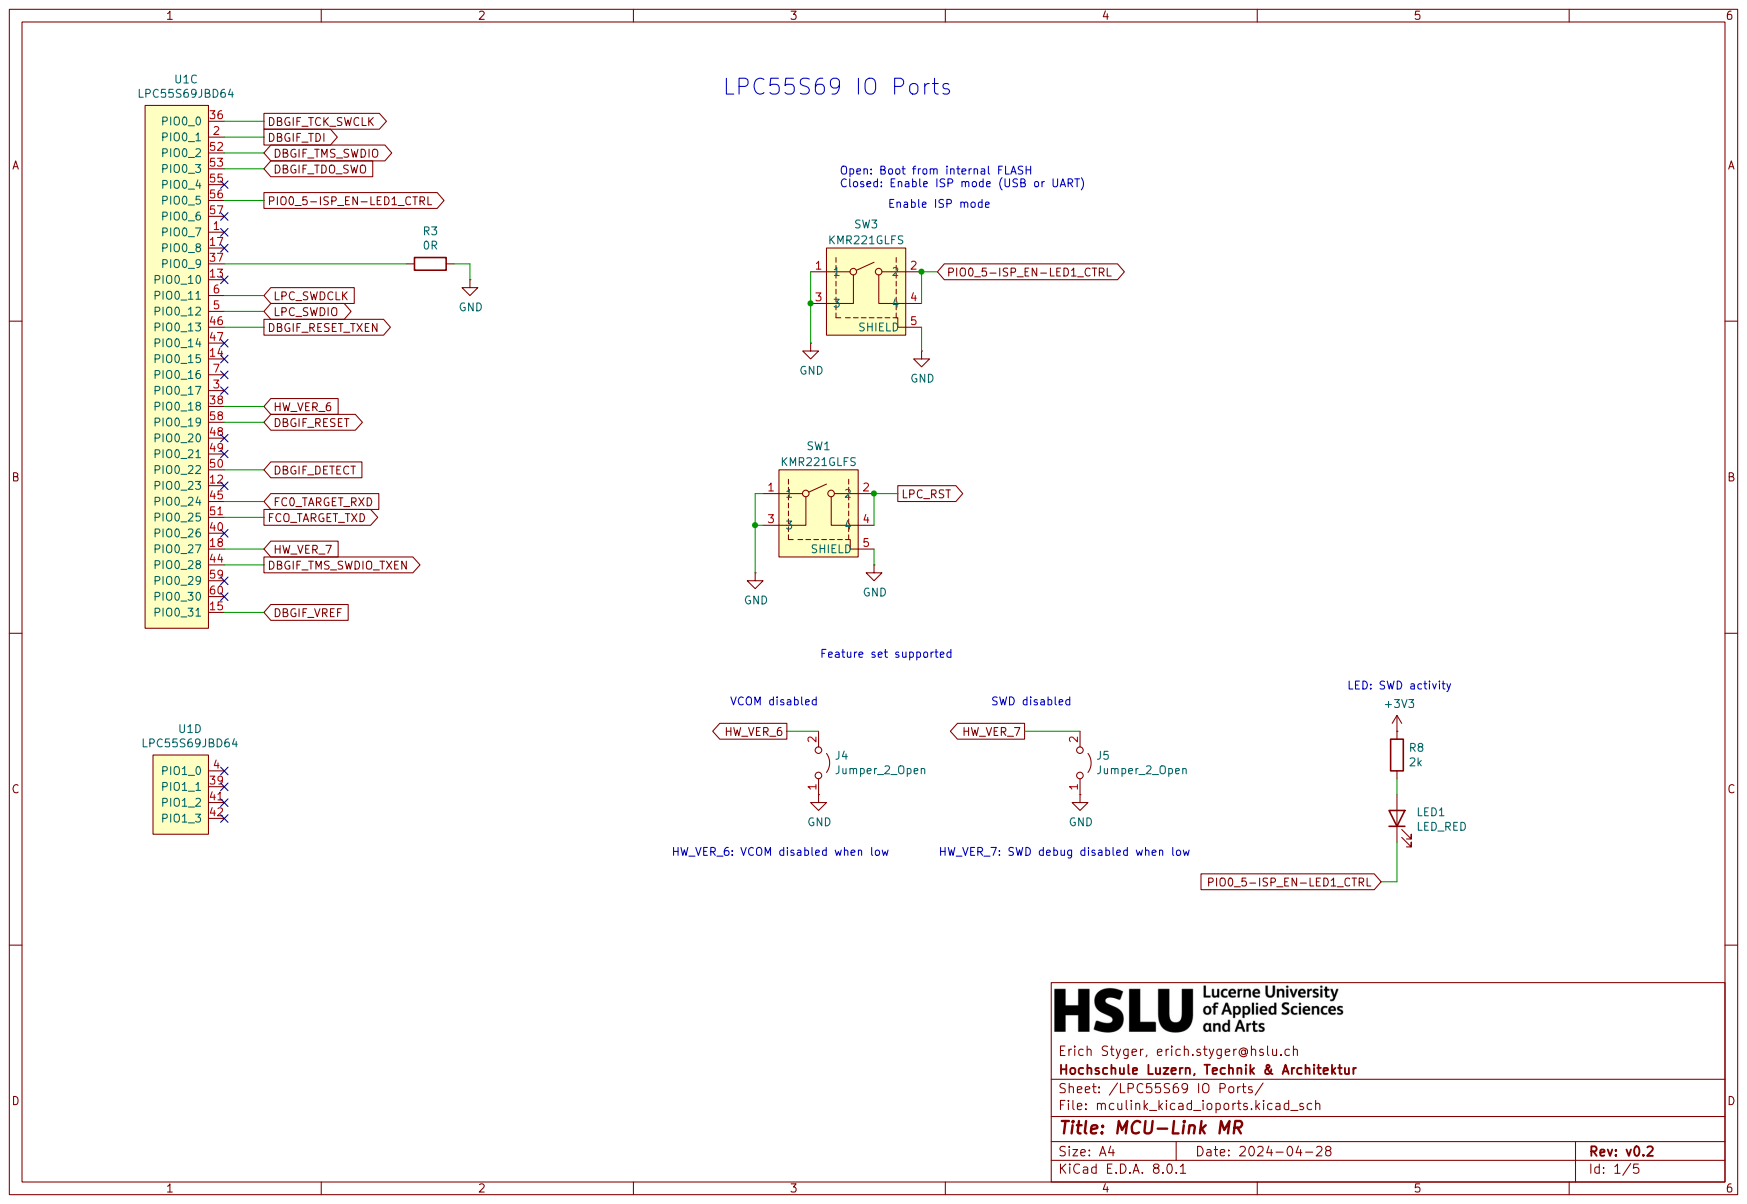
[picture p27: page 3]

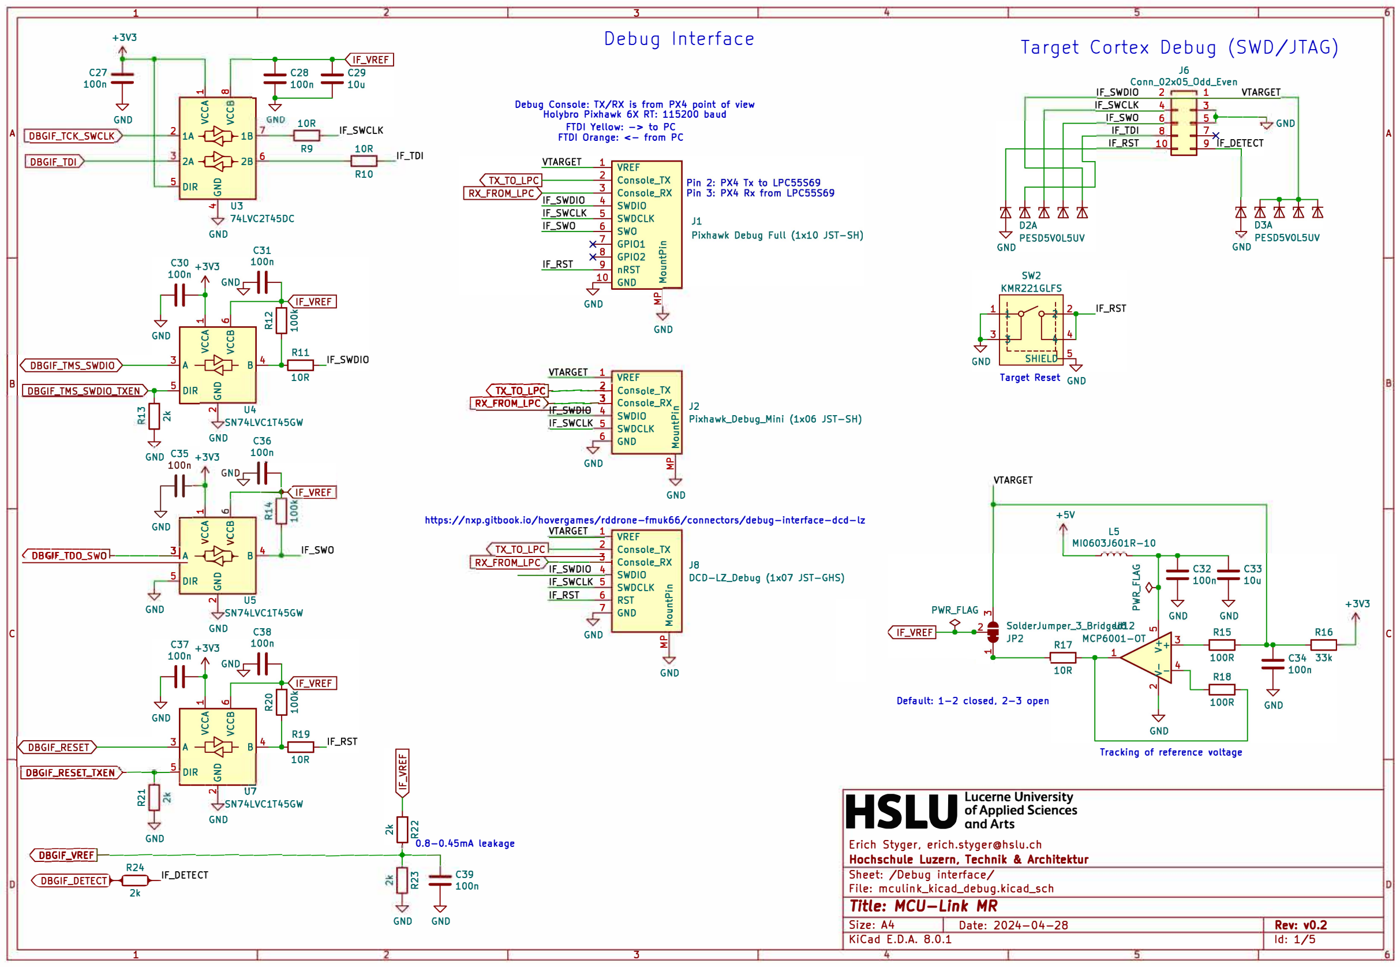
[picture p28: page 4]

1

+3V3
C27
100nTGND
... | "'

<(

u | u u | u > > | 10R
A DBGIF _TCK_SWCLK 2 1A-$1B

C

DBGIF _T DI

"'

2A-$2B

S DIR Cl

z
"'

.;- U3

6

R9

74LVC2T45DC

GND

GND

Cl
z
"'

C31

N U4

10R
SN74LVC1 T45GW
GND | C36
GND C35 +3V3 | 100n
l . | :·r-':<._I_Fi___
GND | <( | "' u | u u | u
<rDiiis:cG"I F,,_Ti'iDiro,_sswwonl----_;3l.-lA -$ B 4 | I F_SWO

S DIR
GND

GND
l__l!_D BGl.c,F -R:':"'Ec?_S'=.ET'=-JcTXENy--77

5 DIR

Cl
z
"'

N US
SN74LVC1 T45GW
GND C38

Cl
z
"'

10R

N ---N-,---,-U;-,:7

"'
GND

SN74LVC1 T45GW
GND

IF _SWCLK
10R
R10

I F_TDI

N
N

"'

3

D e b u g I n t e rf a c e | Ta r g et C o rte x D e b u g ( S W D / JT AG )
Debug Console: TX/RX is from PX4 point of view Holybro Pixhawk 6X RT: 115200 baud
FTDI Yellow: -> to PC
FTDI Orange: <- from PC

GND
GND
VTARGET 1 VREF
r;;,[•-l'T

i,

)(_TT

,}0
1

_L1
P;r=

C

;

1-

:_

-_-_-_-_-_-_-'
2

;j Console_TX
R)(_FROM_LPC IF _SWDIO 4 Console_RX J2 I F_SWCLK S
SWDIO | ii: Pixhawk_Debug_Mini (1x06 JST-SH)
SWDCLK |
6 GND |
GND | Q.

:,:

GND

Target Reset GND

VTARGET
+SV

J6
Con n_02x05_0dd_Even
IF _SWDIO 2 1 VTARGET
IF _5WCLK 4 3
I F_SWO | 6 5 +----7
IF _TDI | 8
IF_RST | 10 GND
| PESDSVOLSUV GND

https :/ / nxp .g itboo k .i o/h ove rga mes/ rd d ro n e-fm u k6 6/ connectors/debug -i nte rf ace-d cd-lz
VTARGET | 1 VREF
T)(_ TQ_LPC | 2 Console_TX

LS
MI0603J601R-10
R)(_FROM LPC >---3
- | --< Console_RX IF _SWDIO 4 SWDIO IF _SWCLK 5 | SWDCLK
IF _RST | 6 RST | 7 GND | 0
GND

:,:

Q.
:,:

GND

J8
DCD-Ll_Debug (1x07 JST-GHS)

Default: 1-2 closed, 2-3 open

HS Lu Lucerne University
of Applied Sciences
and Arts

Tracking of reference voltage
0.8-0.45mA leakage
(]DBGlifF _;;,vRE£F}---------------------t--7 R24 IF _DETECT

Erich Styger, erich.styger@hslu.ch

Hochschule Luzern, Technlk & Archltektur
2k

1

"' C39 N
"' T

100n
GND GND
3

Sheet: /Debug interface/
File: mcu lin k_kicad_debug.kicad_sch

Title: MCU-Unk MR

Size: A4 Date: 2024-04-28
KiCad E.D.A. 8.0.1
Rev: v0.2

Id: 1/5

A

+3V3

C

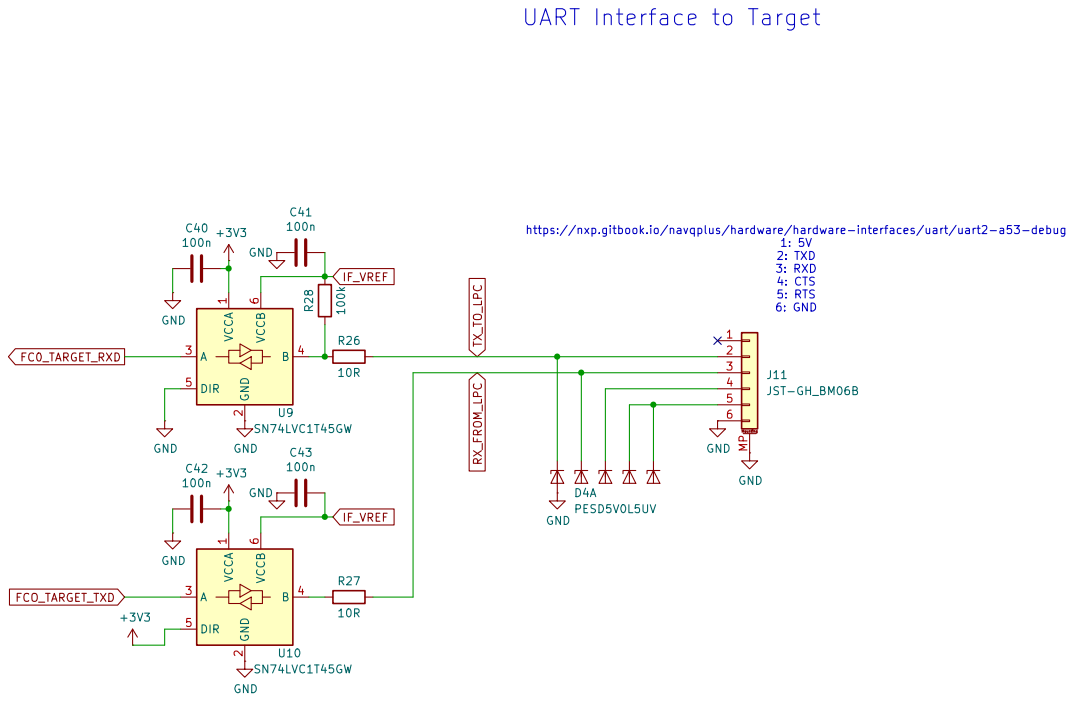
[picture p29: page 5]
