ErichStyger/MCU-Link-MR/KiCAD/MCU-Link_MR/v0.4/MCU-Link MR v0.4 Schematic.pdf

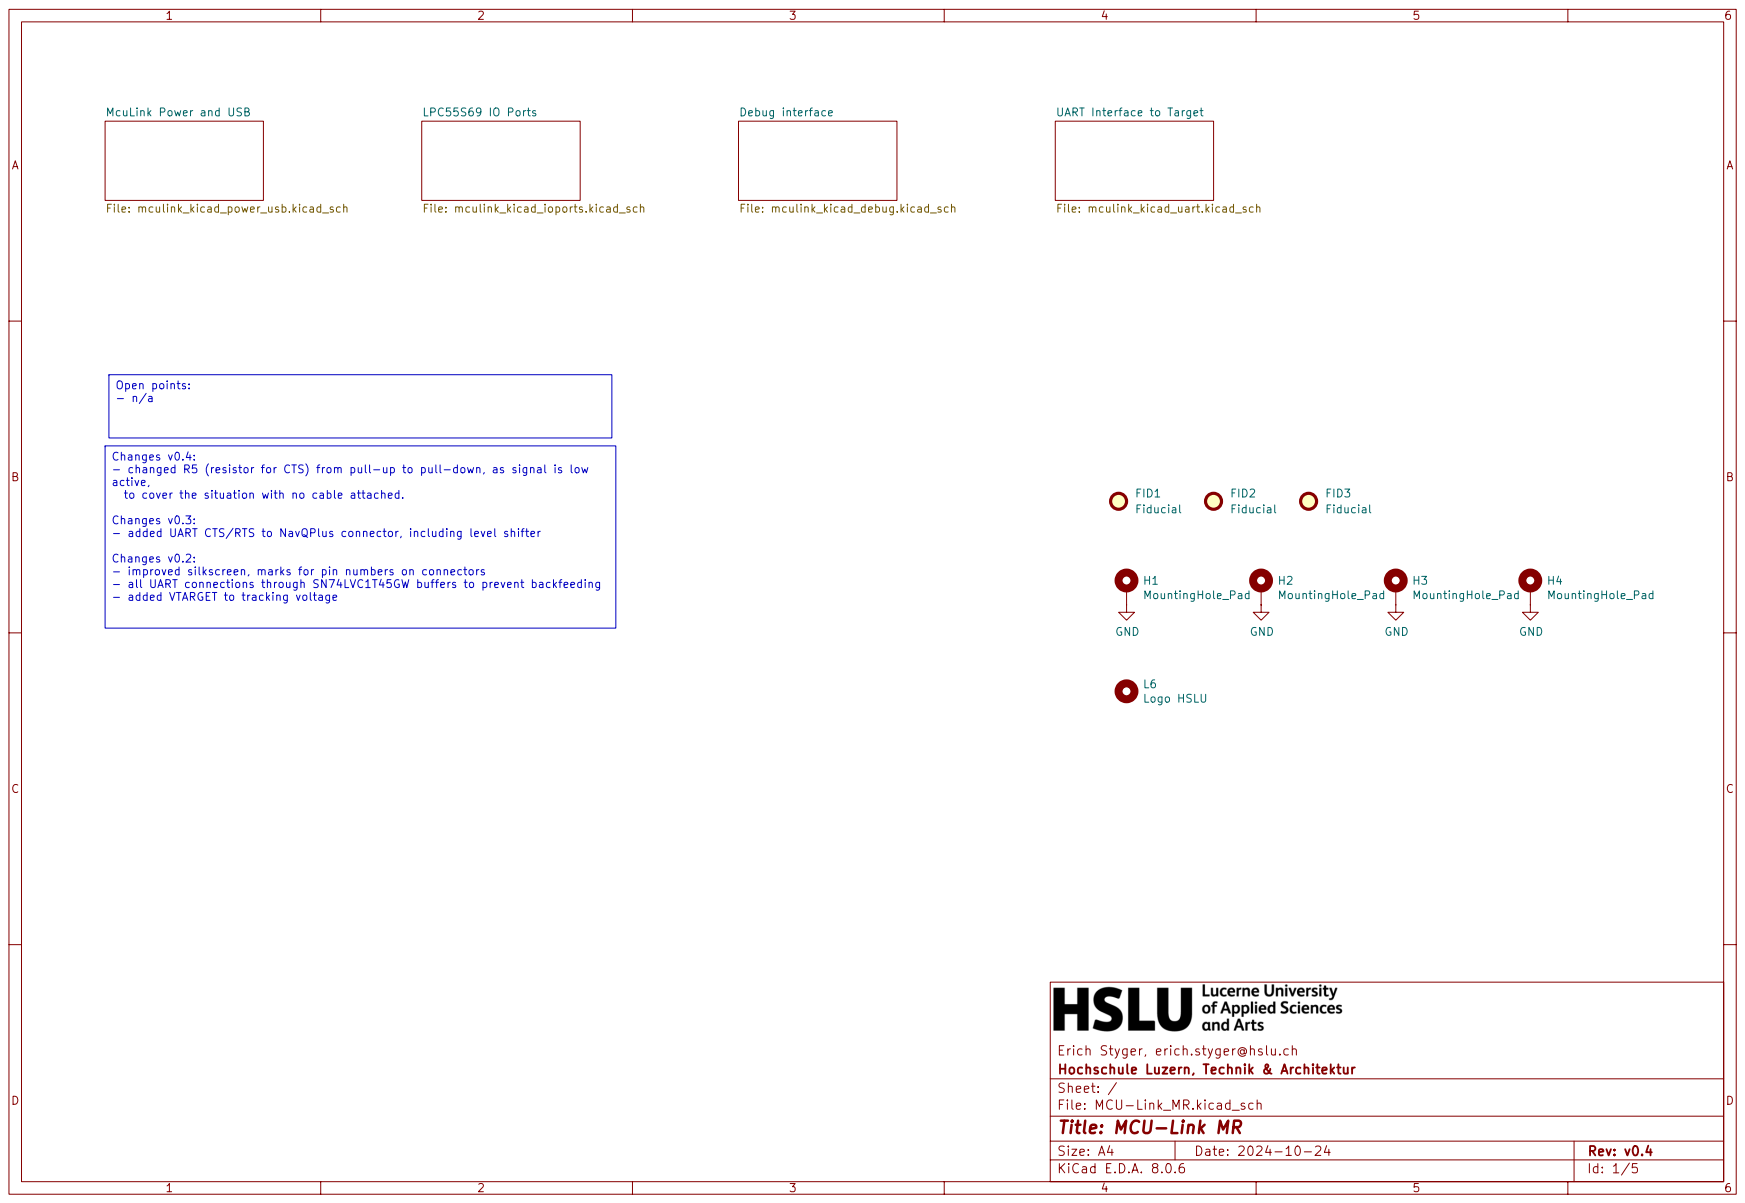
[picture p30: page 1]

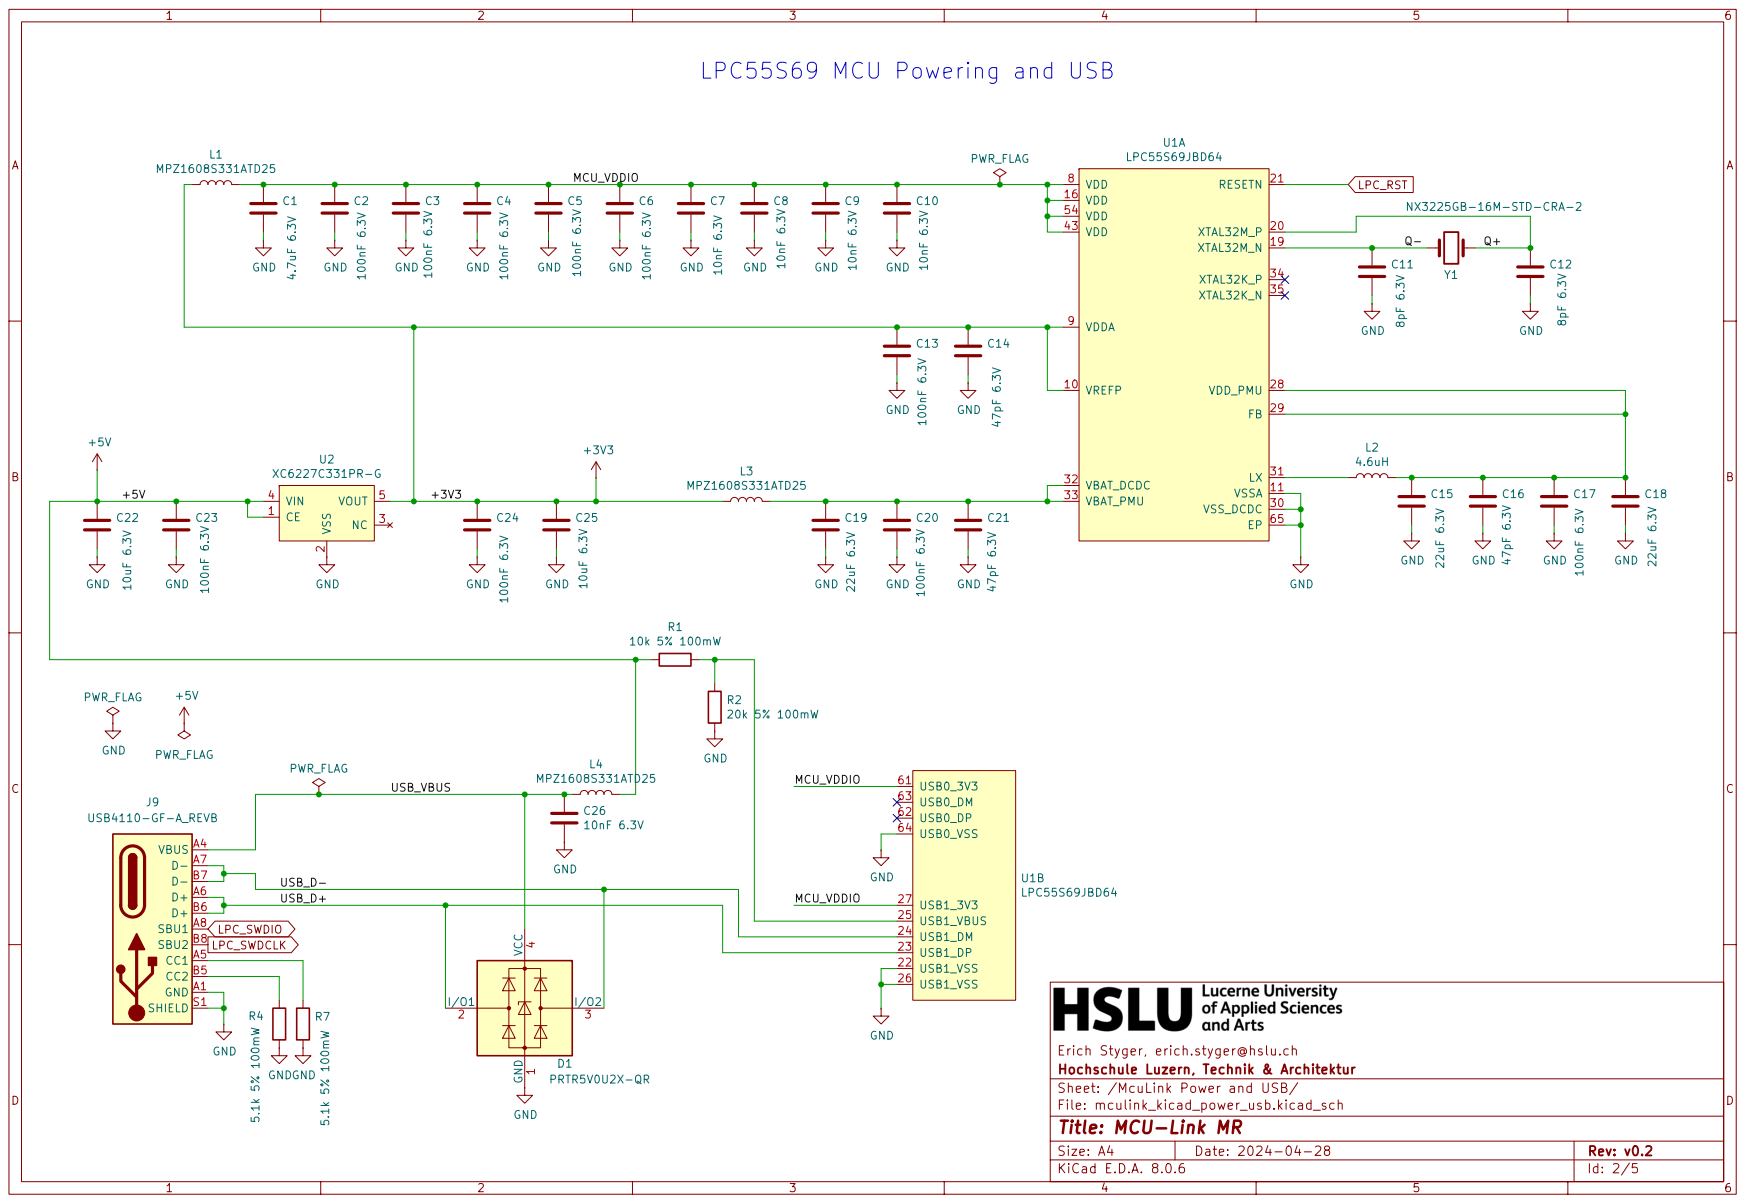
[picture p31: page 2]

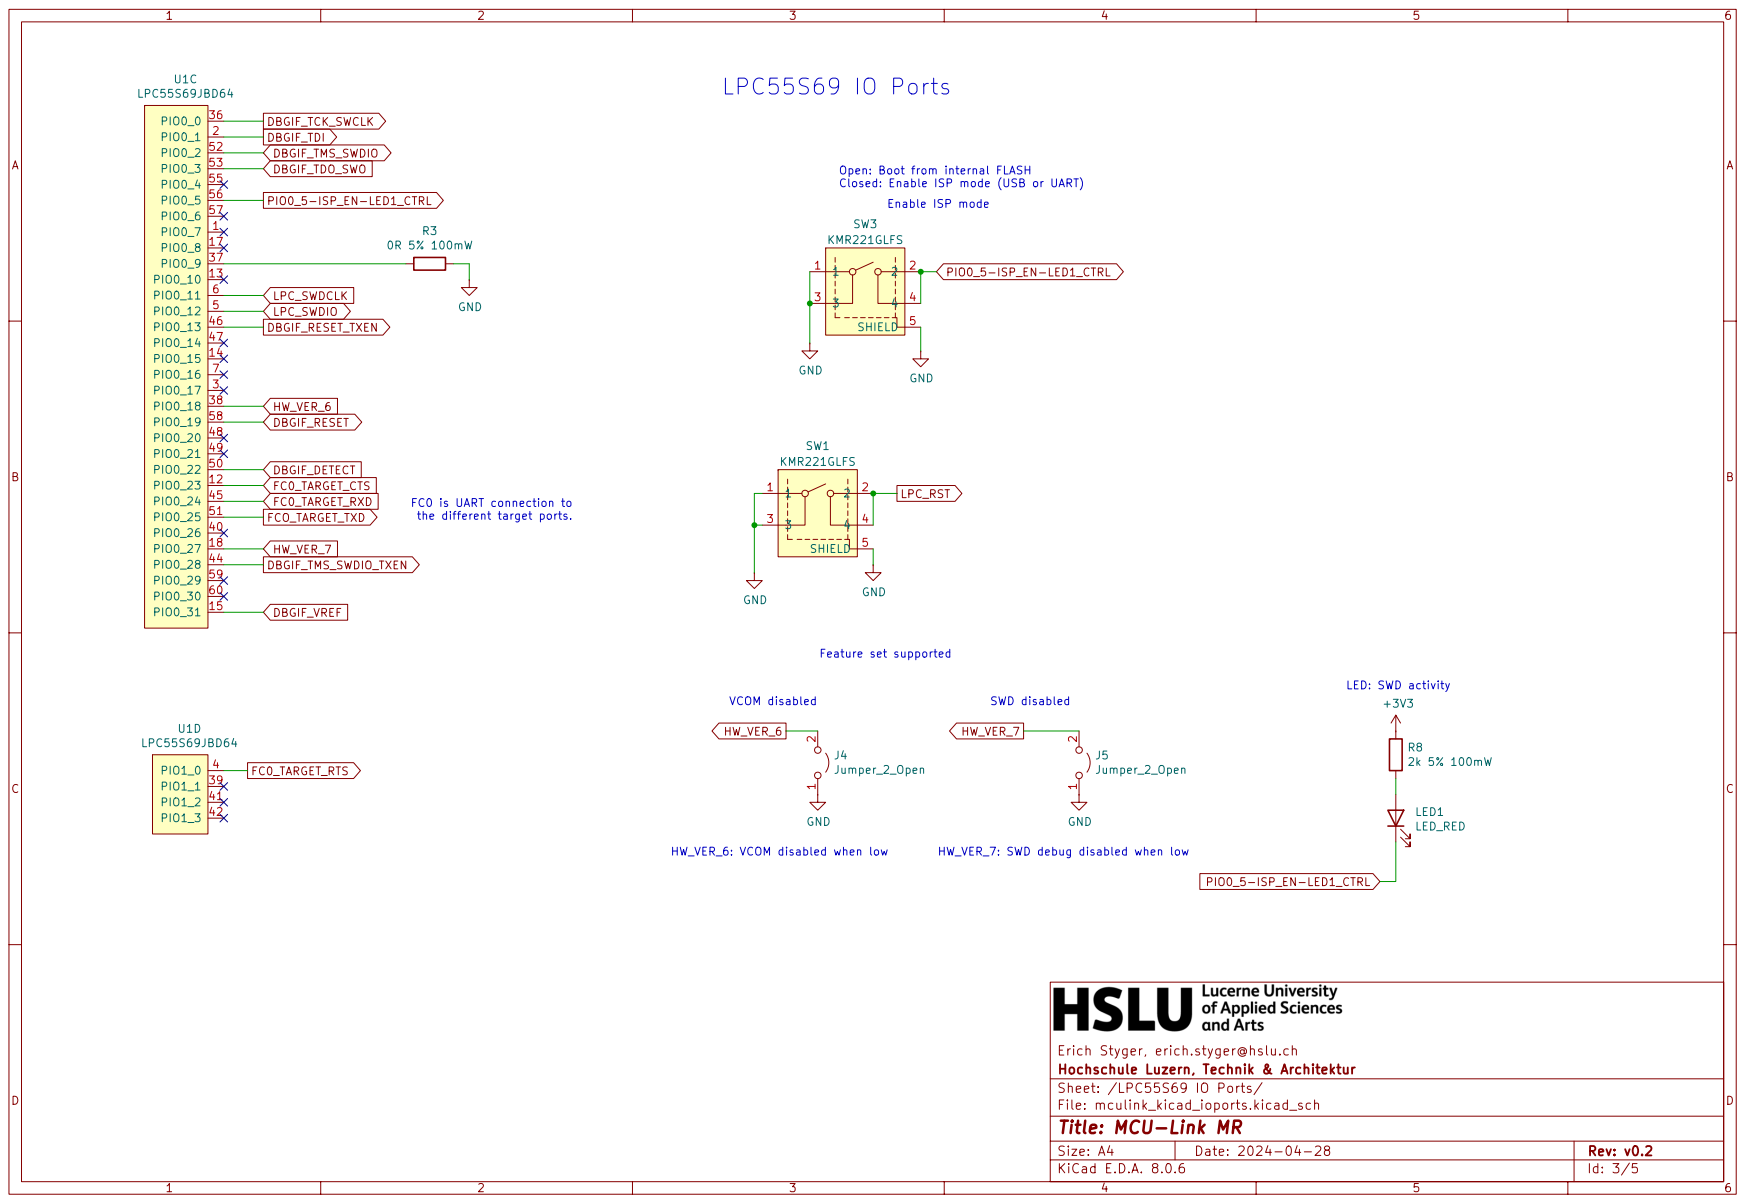
[picture p32: page 3]

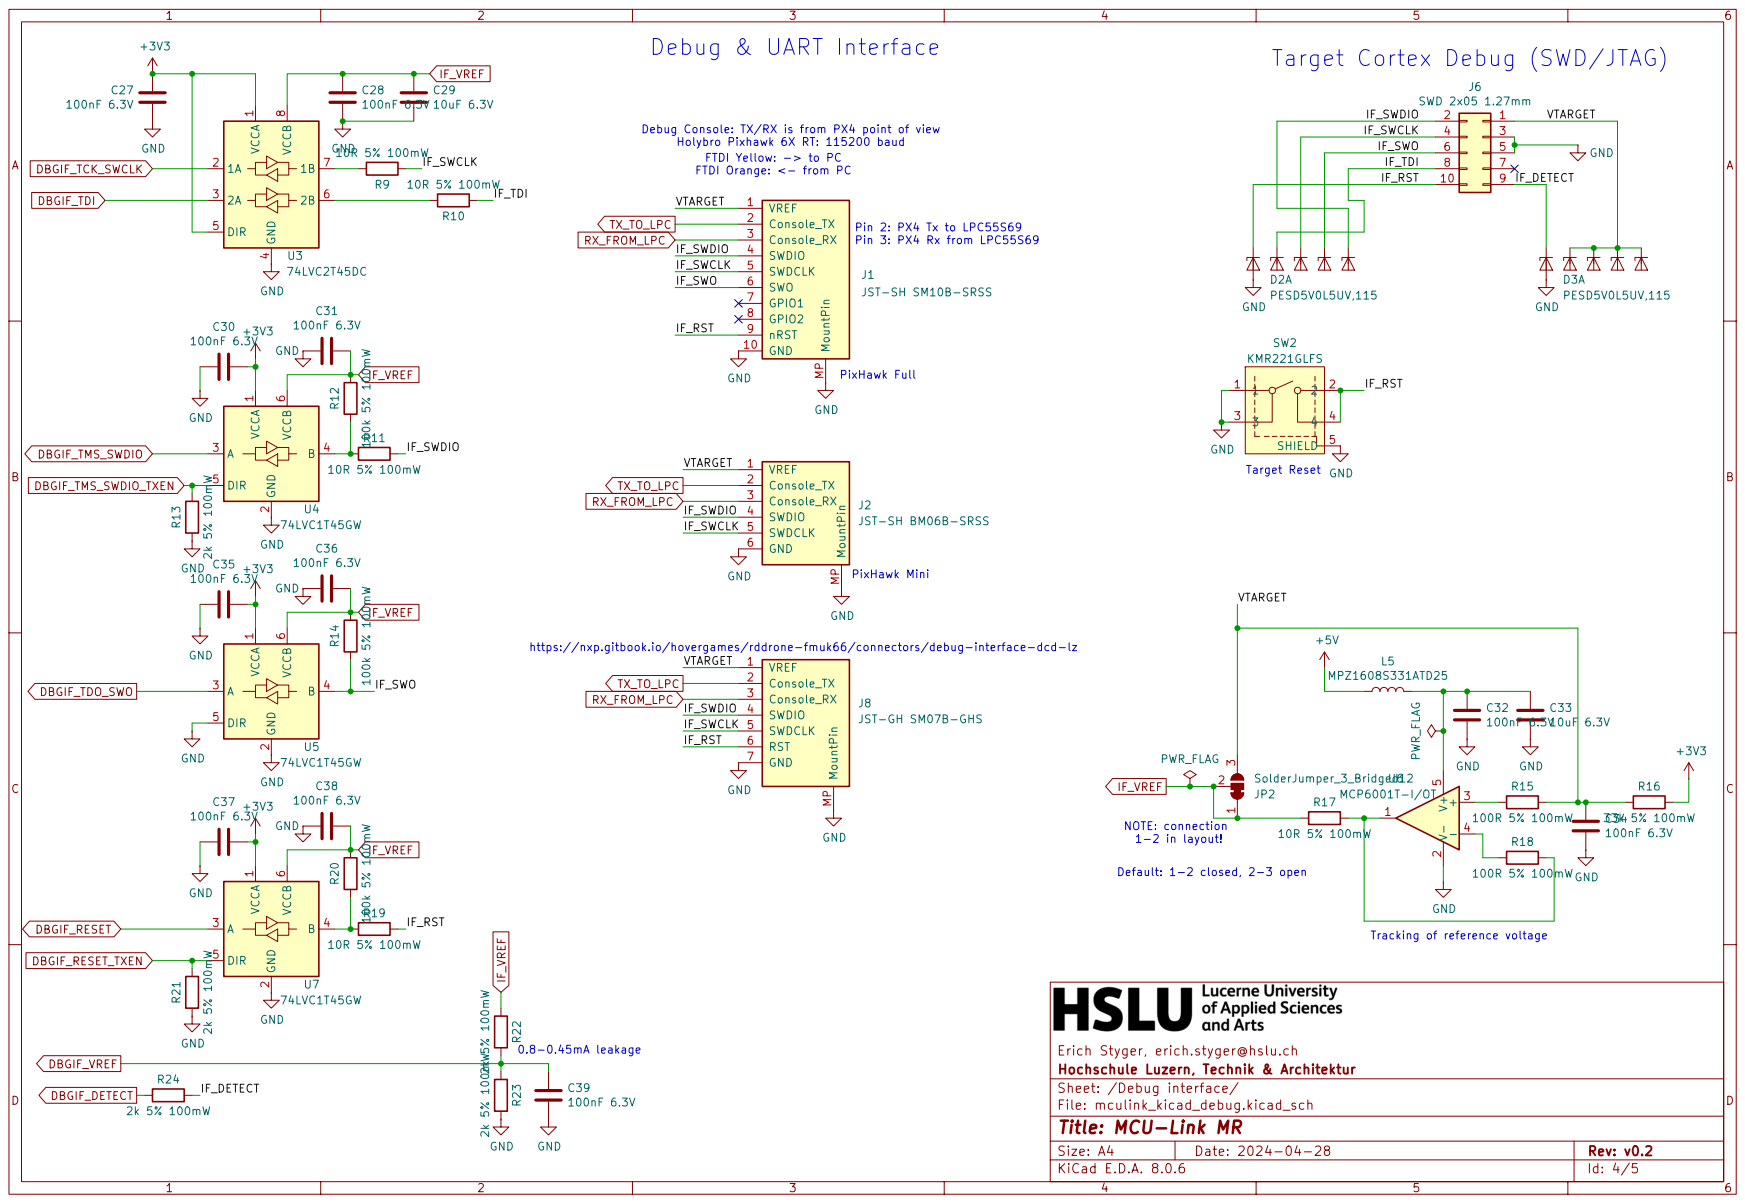
[picture p33: page 4]

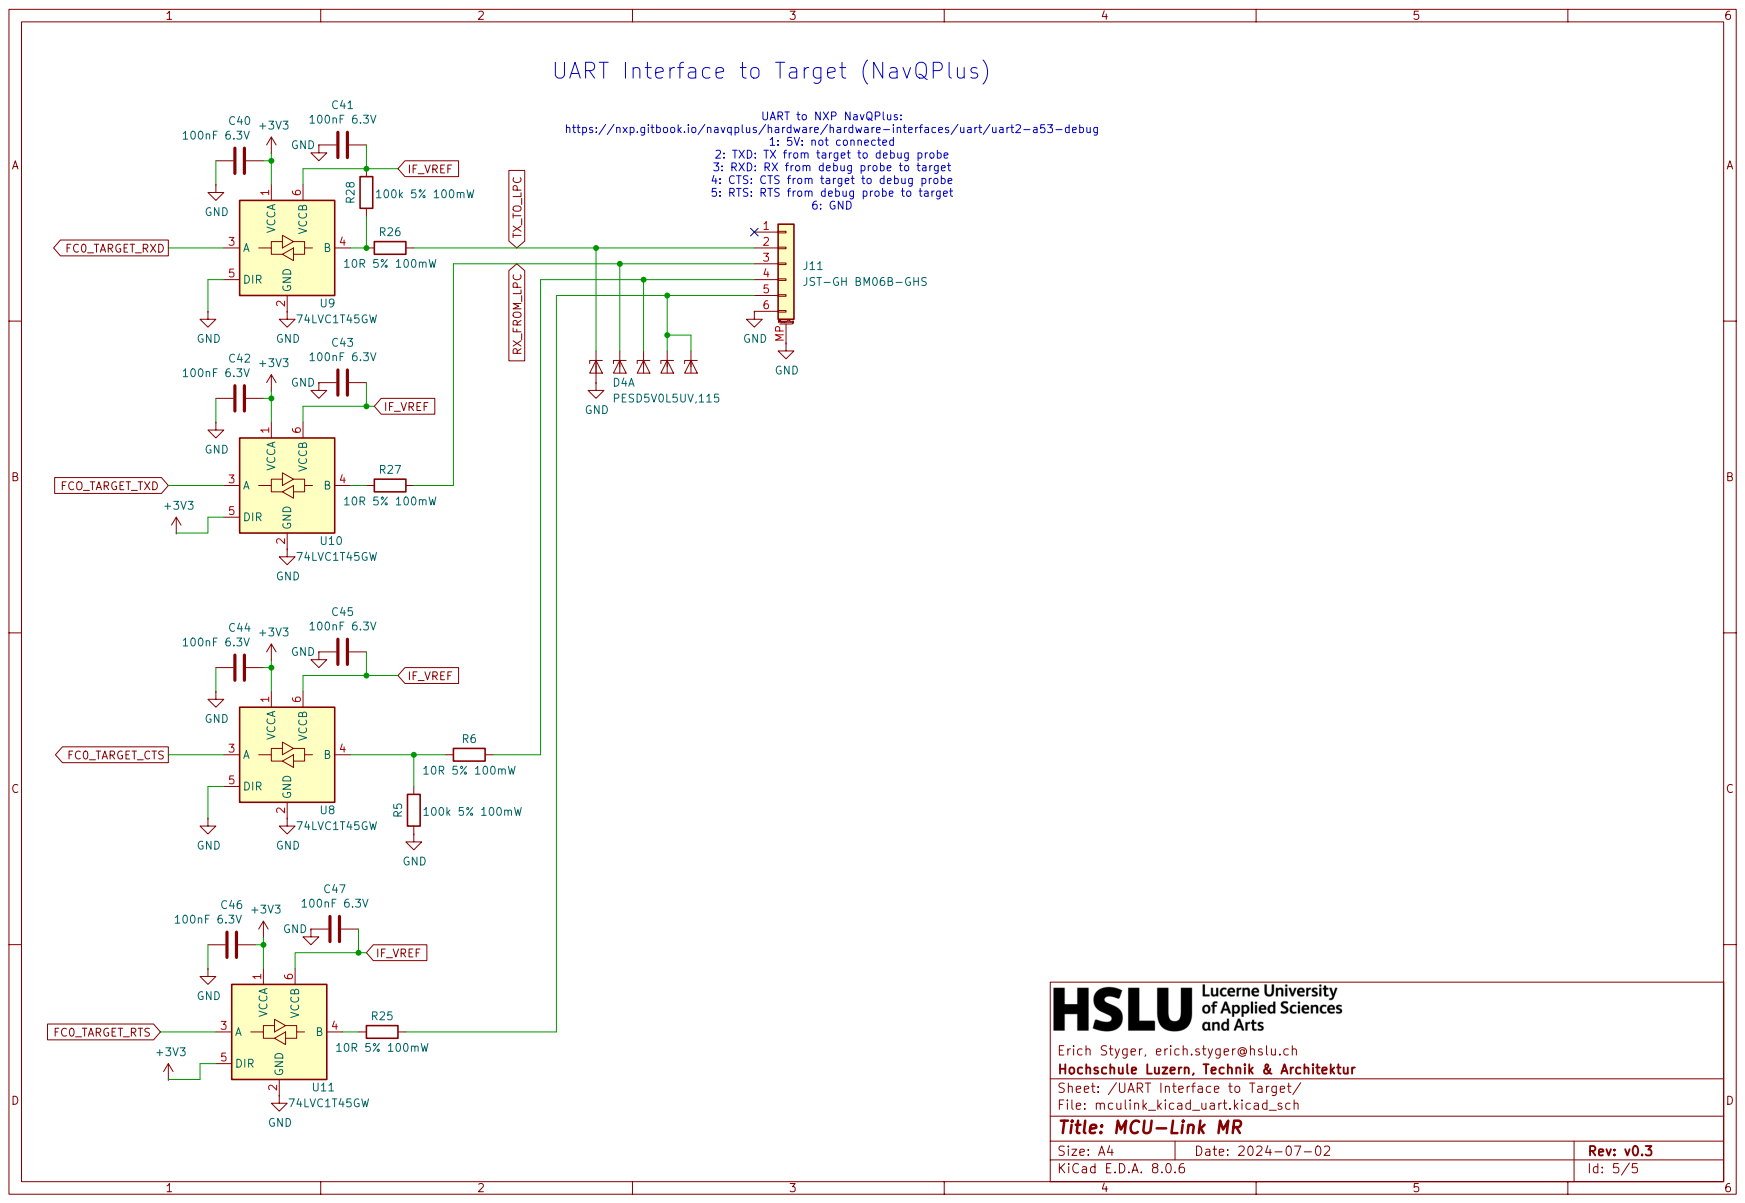
[picture p34: page 5]
