ErichStyger/MCU-Link-MR/KiCAD/MCU-Link_MR/v0.3/Schematic MCU-LINK-MR v0.3.pdf

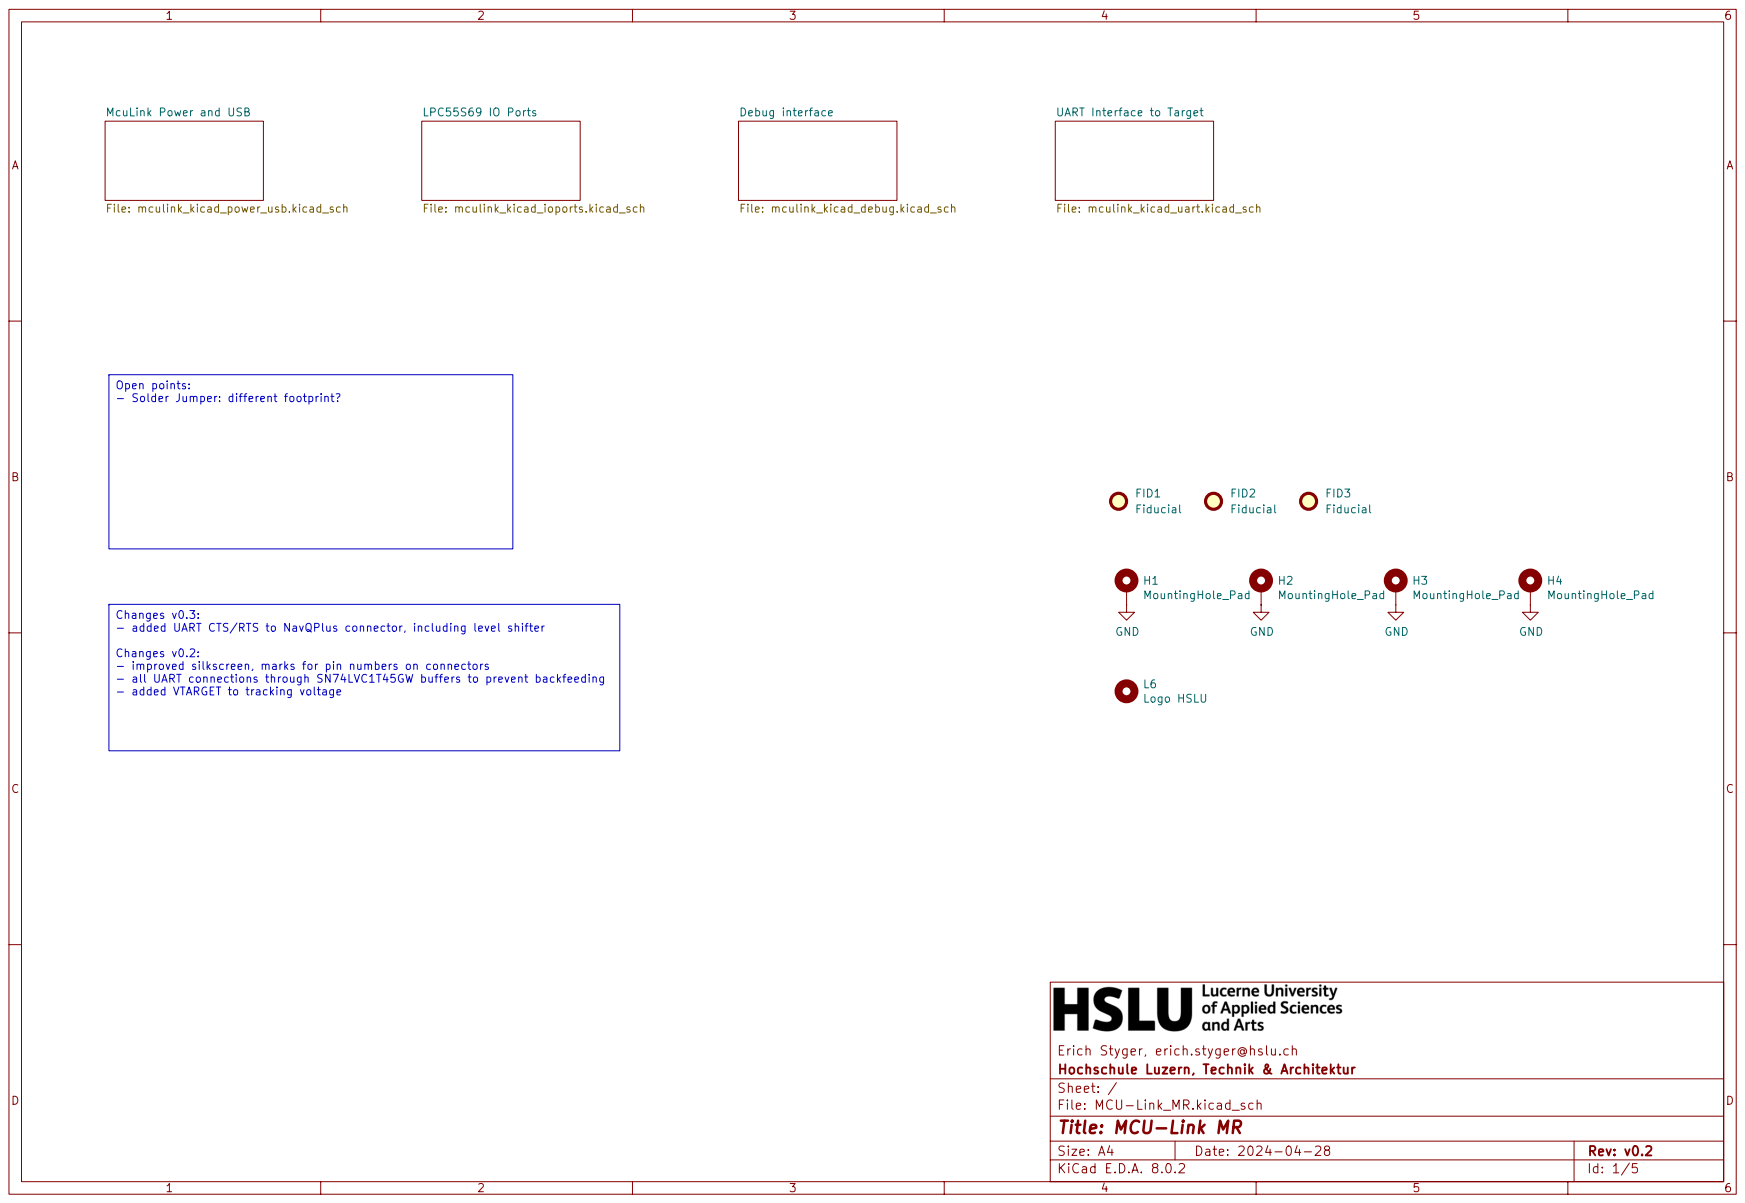
[picture p35: page 1]

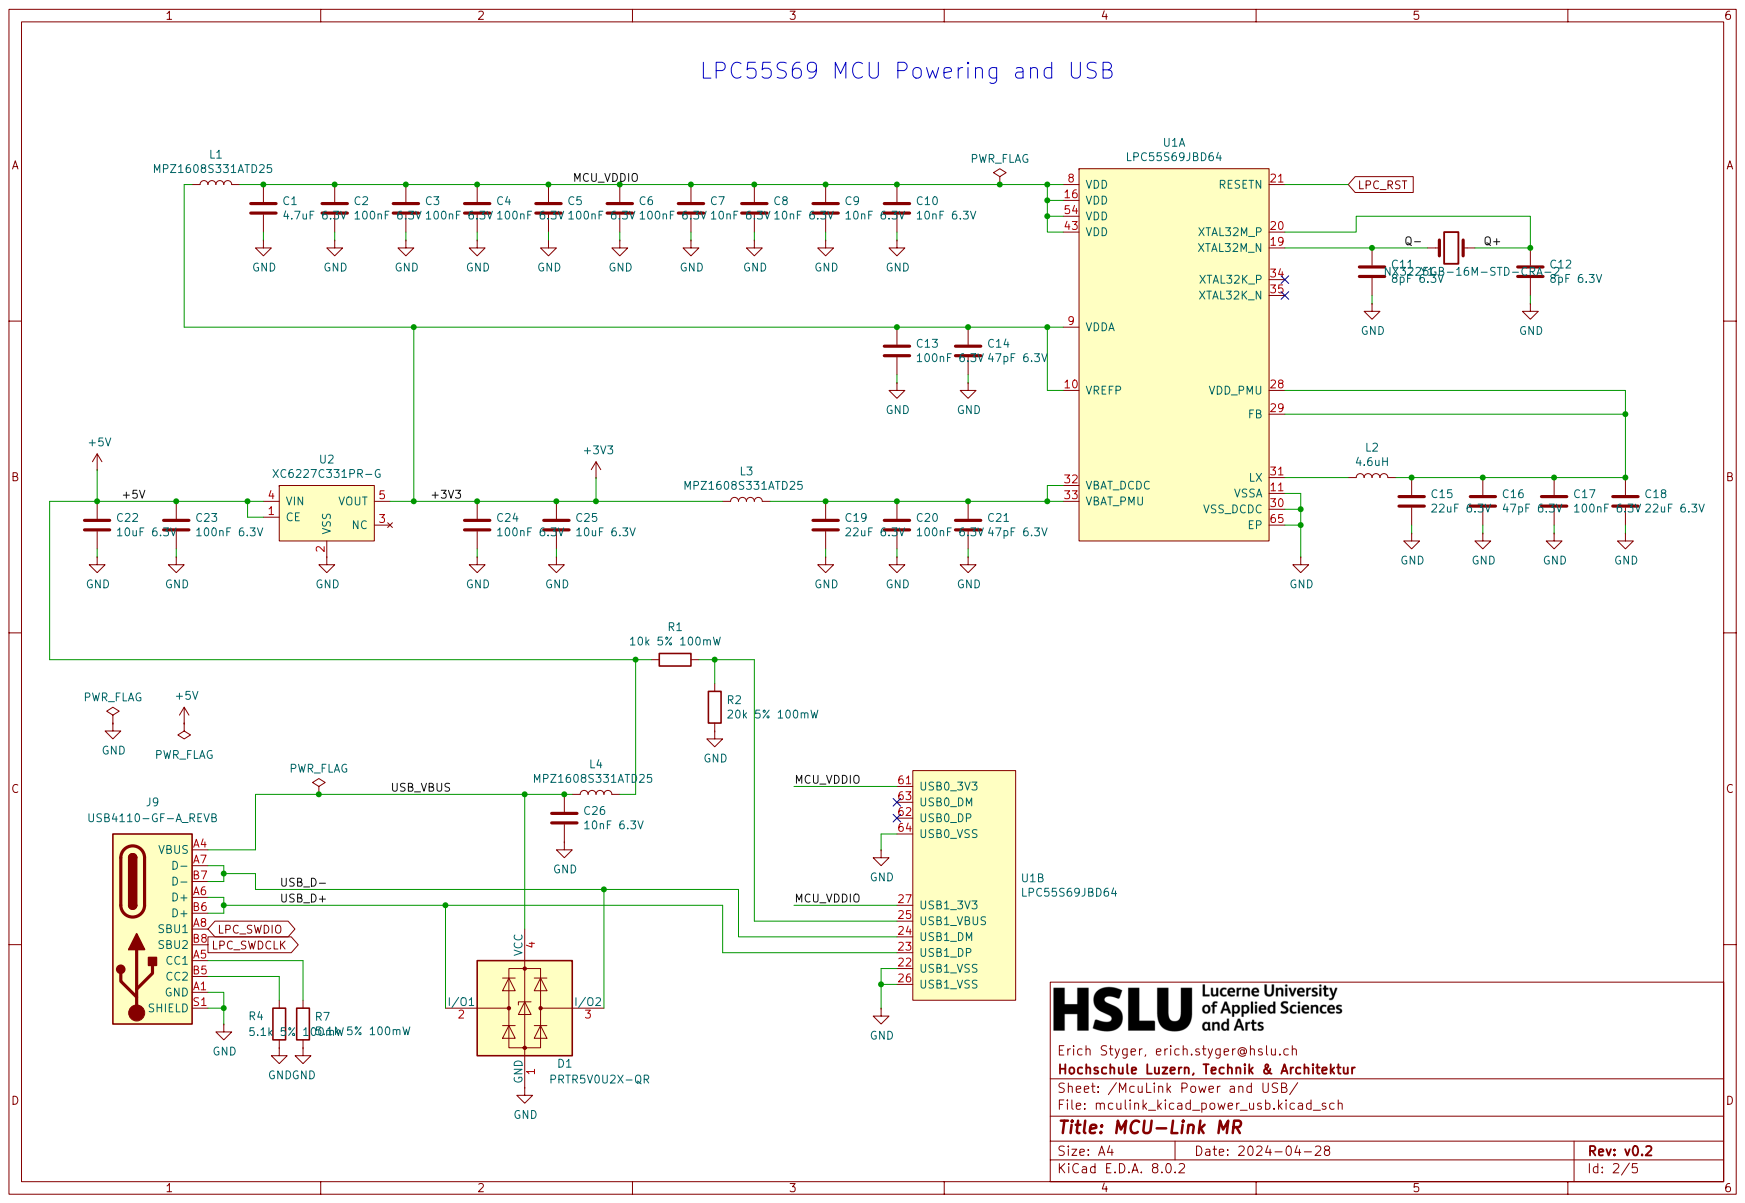
[picture p36: page 2]

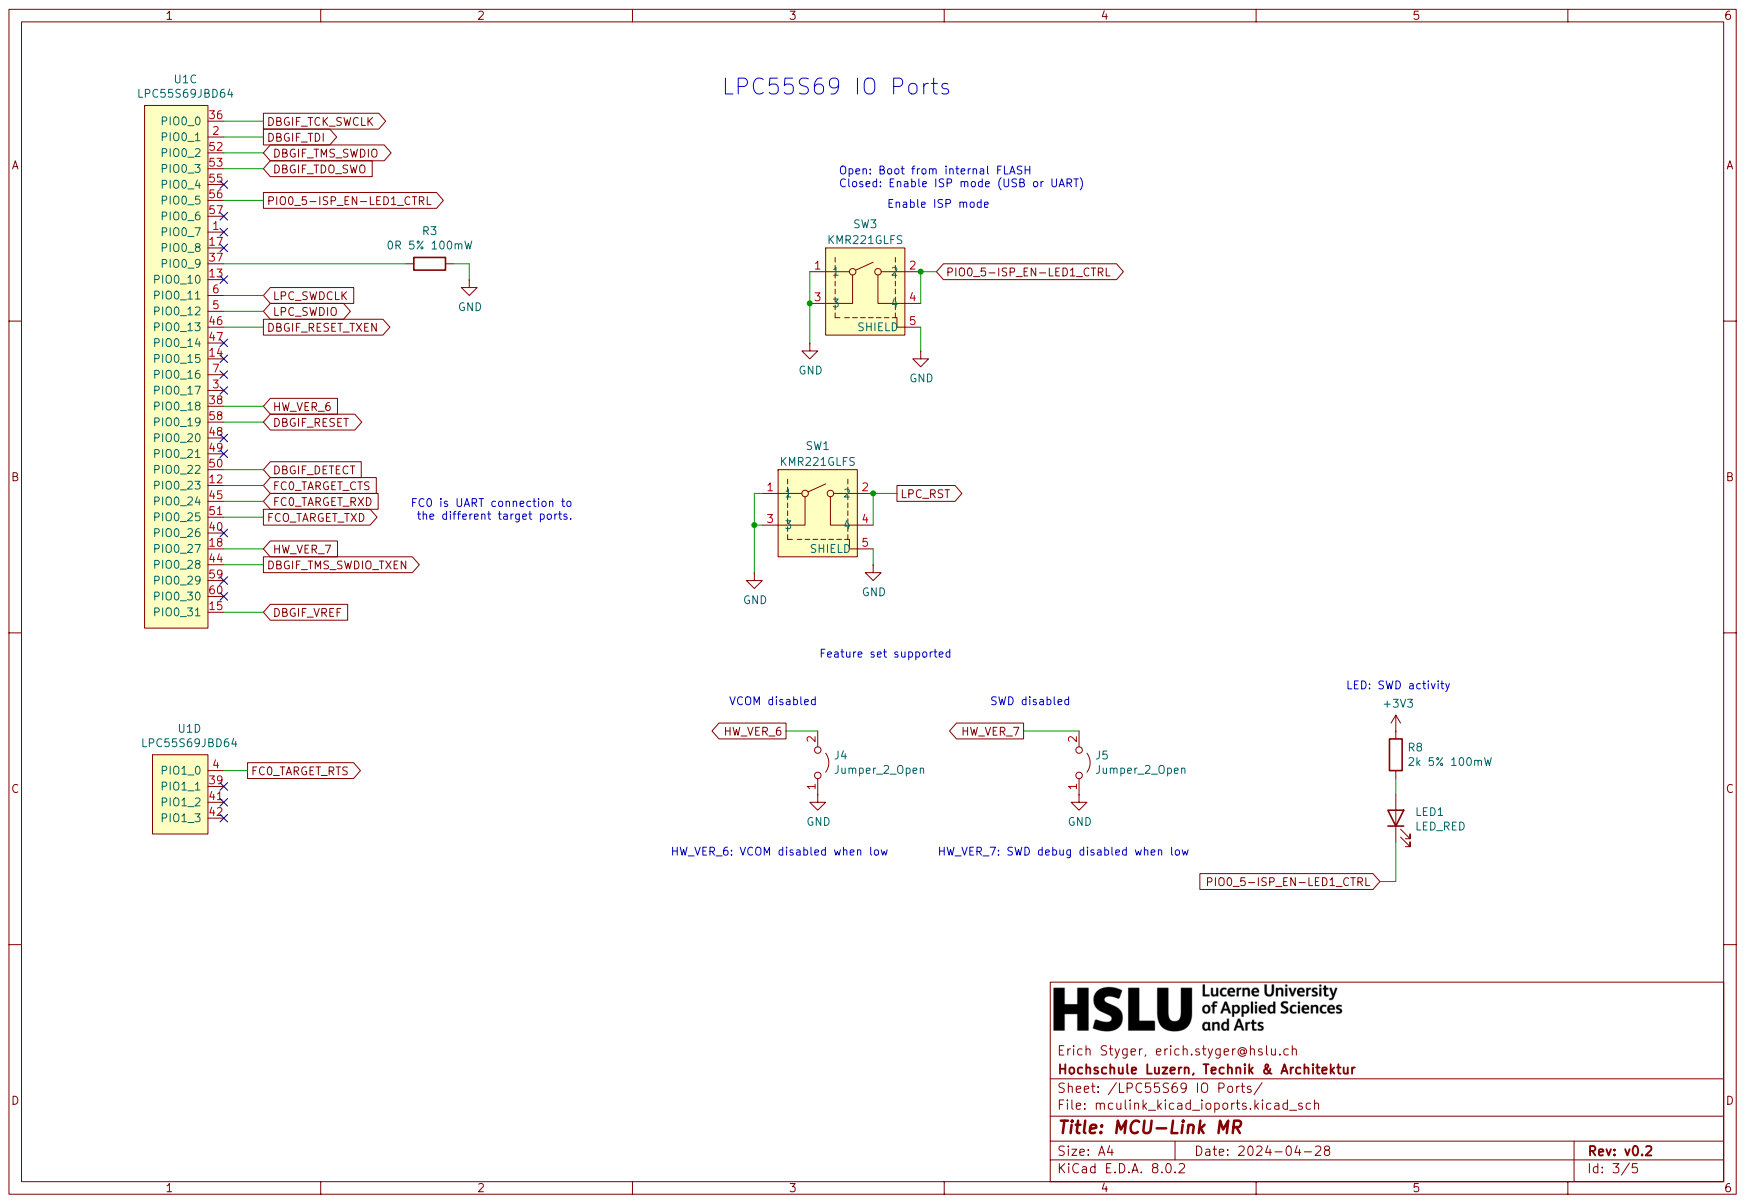
[picture p37: page 3]

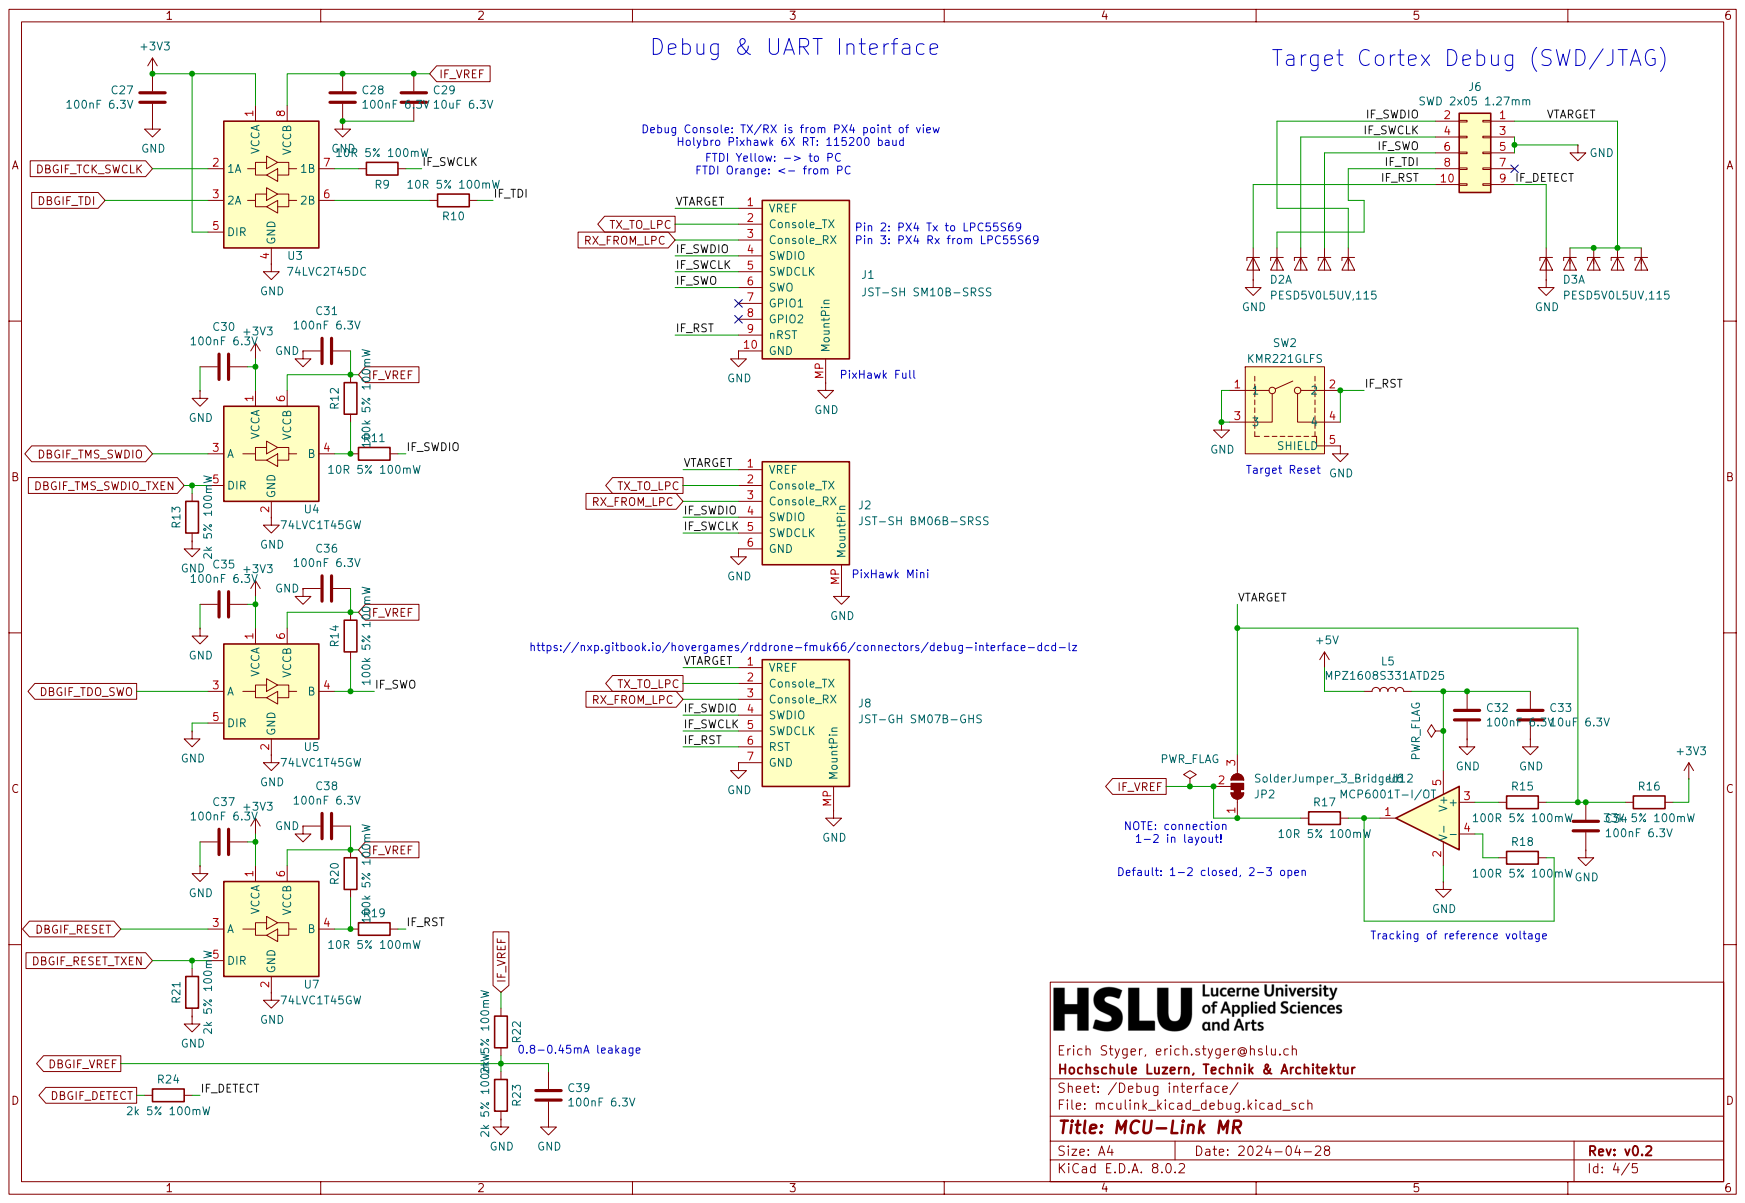
[picture p38: page 4]

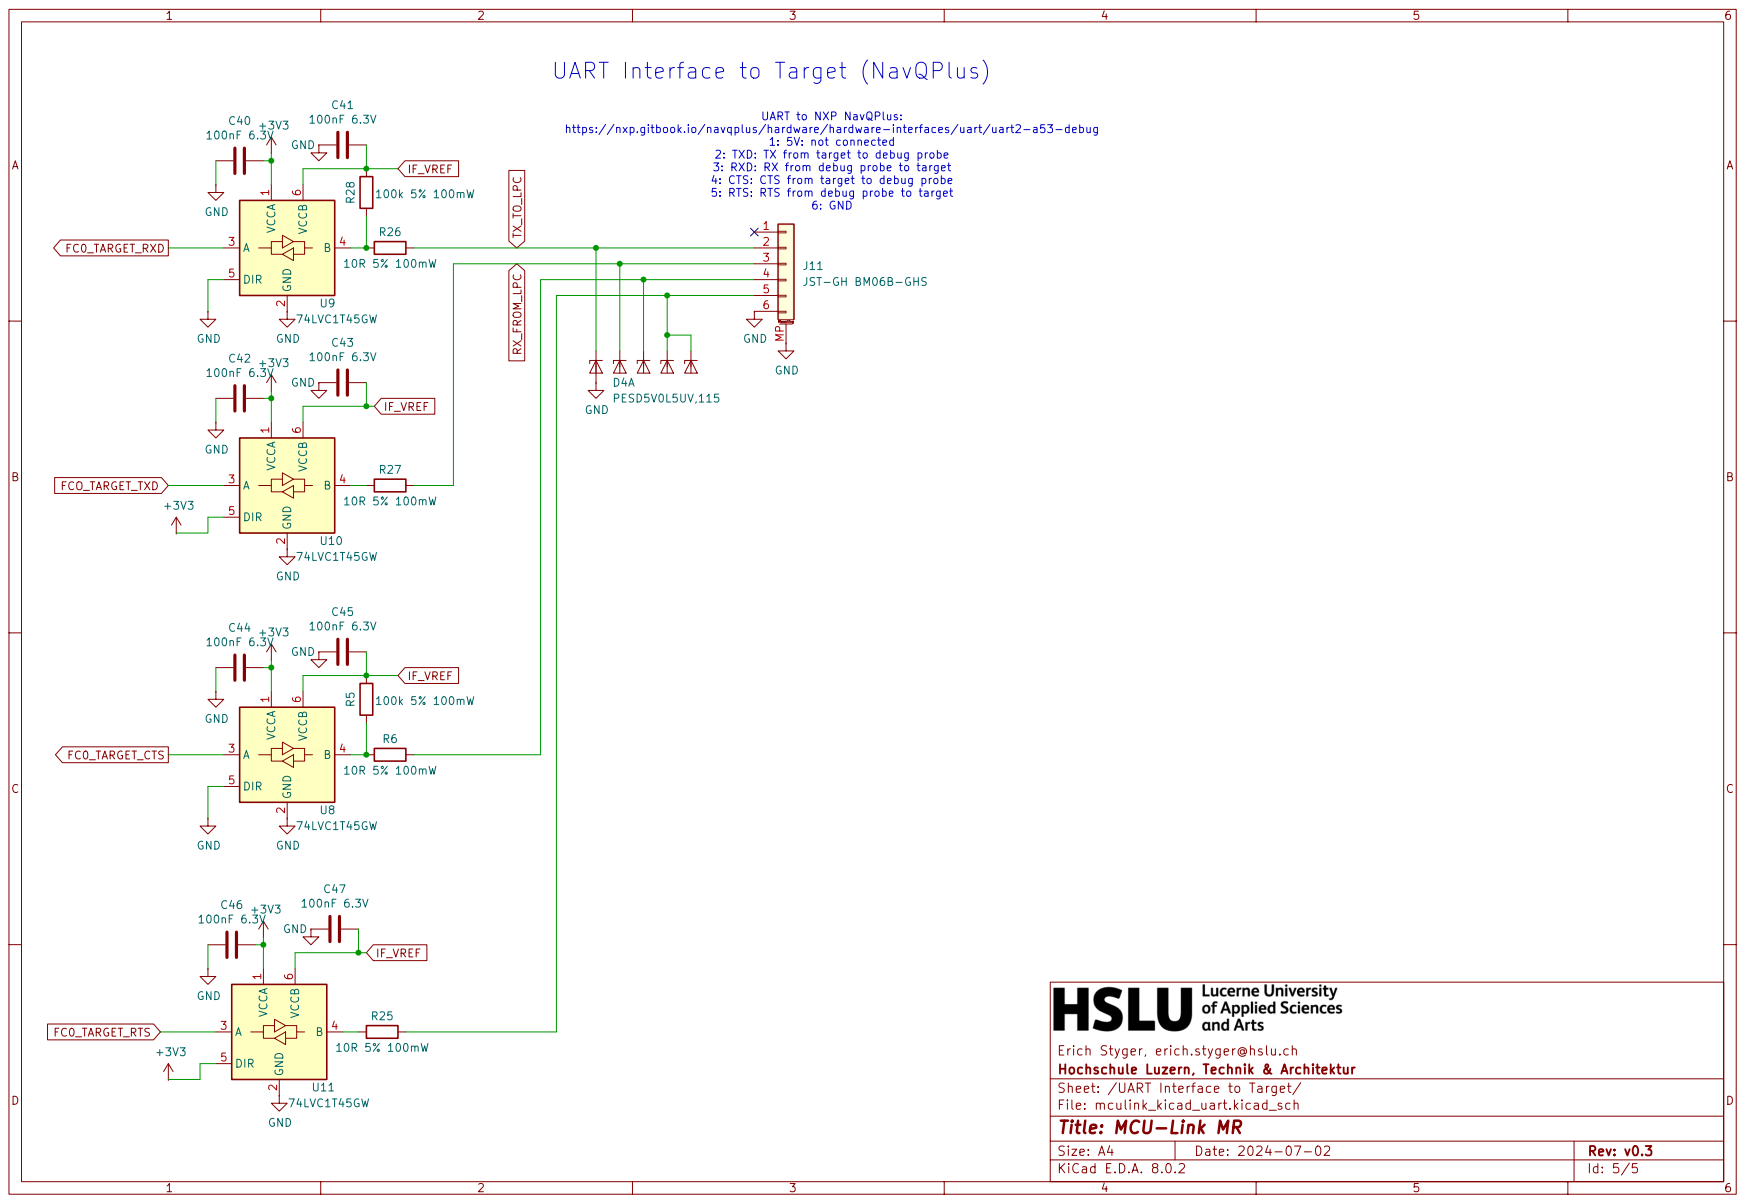
[picture p39: page 5]
