ErichStyger/MCU-Link-MR/(commit log)

2024-05-05 moved files to new repository
    [BOM.xlsx, MCU-Link_MR.kicad_pcb, MCU-Link_MR.kicad_sch, mculink_kicad.sch, mculink_kicad_debug.kicad_sch, mculink_kicad_debug.sch, mculink_kicad_ioports.kicad_sch, mculink_kicad_ioports.sch]
2024-05-13 better BOM
    [MCU-Link_MR.kicad_sch, mculink_kicad_debug.kicad_sch, mculink_kicad_ioports.kicad_sch]
2024-05-19 enclosure for v0.2
2024-05-19 completed BOM
    [MCU-Link_MR.kicad_pcb, MCU-Link_MR.kicad_sch, mculink_kicad_debug.kicad_sch, mculink_kicad_ioports.kicad_sch, mculink_kicad_power_usb.kicad_sch, mculink_kicad_uart.kicad_sch]
2024-05-19 added BOM output
    [bom_mr_v0.2.csv]
2024-07-03 updates for v0.3: added RTS/CTS signals for J11
    [MCU-Link_MR.kicad_pcb, MCU-Link_MR.kicad_sch, mculink_kicad_debug.kicad_sch, mculink_kicad_ioports.kicad_sch, mculink_kicad_power_usb.kicad_sch, mculink_kicad_uart.kicad_sch]
2024-07-03 added v0.3 version (experimental)
    [MCU-Link_MR.kicad_pcb]
2024-07-16 updated BOM part numbers for v0.3
    [mculink_kicad_uart.kicad_sch]
2024-07-17 simplified footprints
    [MCU-Link_MR.kicad_pcb, mculink_kicad_power_usb.kicad_sch]
2024-08-09 footprint and part number for C15, C18 and C19
    [bom_mr_v0.2.csv]
2024-10-24 new v0.4 with pull-down for cts signal (instead pull-up)
    [MCU-Link_MR.kicad_pcb, MCU-Link_MR.kicad_sch, mculink_kicad_debug.kicad_sch, mculink_kicad_power_usb.kicad_sch, mculink_kicad_uart.kicad_sch]
2024-10-31 renamed gerber file
2024-11-12 added open point
    [MCU-Link_MR.kicad_sch]
2024-11-24 Updates on silkscreen
    [MCU-Link_MR.kicad_pcb, mculink_kicad_debug.kicad_sch]
2024-11-24 ideas for next version
    [MCU-Link_MR.kicad_sch]
2024-11-29 added notes for next version
    [MCU-Link_MR.kicad_pcb, MCU-Link_MR.kicad_sch]
2024-12-03 'fixed' JP2 jumper in v0.2 schematic: it is a Jumper-3 with 1-2 closed by default. KiCad had some issues with it, cleared it in the schematics.
2024-12-03 minor board updates around JP2 handling
    [MCU-Link_MR.kicad_pcb, MCU-Link_MR.kicad_sch, mculink_kicad_debug.kicad_sch, mculink_kicad_ioports.kicad_sch]
2024-12-03 added note about reference voltage
    [mculink_kicad_debug.kicad_sch]
2024-12-16 Replaced 0603 with 0402 footprints for C and R; removed designators; shifted components to the left
    [MCU-Link_MR.kicad_pcb, MCU-Link_MR.kicad_sch, mculink_kicad_debug.kicad_sch, mculink_kicad_ioports.kicad_sch, mculink_kicad_power_usb.kicad_sch, mculink_kicad_uart.kicad_sch]
2024-12-16 Add NXP logo on back silkscreen
2024-12-16 Added logic analyzer pin header for easy access to Pixhawk GPIO 1 + 2
    [MCU-Link_MR.kicad_pcb, MCU-Link_MR.kicad_sch, mculink_kicad_debug.kicad_sch]
2024-12-16 Replaced faulty solder jumper with bridged jumper; no fix currently (https://forum.kicad.info/t/6-99-drc-fail-solder-mask-aperture-bridges-items-with-different-nets/35311)
    [MCU-Link_MR.kicad_pcb, mculink_kicad_debug.kicad_sch]
2024-12-16 added silkscreen for GPIO1 and 2, improved back GND plane a bit
    [MCU-Link_MR.kicad_pcb]
2025-02-07 routed logic analyzer pins
    [MCU-Link_MR.kicad_pcb, MCU-Link_MR.kicad_sch, mculink_kicad_debug.kicad_sch, mculink_kicad_ioports.kicad_sch, mculink_kicad_power_usb.kicad_sch, mculink_kicad_uart.kicad_sch]
2025-03-11 updated BOM
    [BOM.xlsx]
2025-07-09 updated to KiCad 9
    [MCU-Link_MR.kicad_sch, mculink_kicad_debug.kicad_sch, mculink_kicad_ioports.kicad_sch, mculink_kicad_power_usb.kicad_sch, mculink_kicad_uart.kicad_sch]
2025-10-29 upgraded to KiCad 9.0.4, fixed DRC warnings
    [MCU-Link_MR.kicad_pcb, MCU-Link_MR.kicad_sch, mculink_kicad_debug.kicad_sch, mculink_kicad_ioports.kicad_sch, mculink_kicad_power_usb.kicad_sch]
2025-10-29 finalized v0.5 for production
    [MCU-Link_MR.kicad_pcb, MCU-Link_MR.kicad_sch, mculink_kicad_debug.kicad_sch, mculink_kicad_uart.kicad_sch]
2025-10-29 added v0.5 PCB information
2025-10-29 minor label placement
    [mculink_kicad_debug.kicad_sch, mculink_kicad_uart.kicad_sch]
2025-11-05 updated BOM with new part numbers
    [MCU-Link_MR_v0.5_BOM.csv, mculink_kicad_debug.kicad_sch, mculink_kicad_ioports.kicad_sch, mculink_kicad_power_usb.kicad_sch, mculink_kicad_uart.kicad_sch]
2026-02-18 added v0.5 enclosure. added cutout for logic analzyer plus slighly moved button holes
2026-07-01 updated labels
    [mculink_kicad_debug.kicad_sch]
